cmc0619/PiTrac/Hardware/codex/Assembly Files/IRLED2 Only PCB/IRLED2 Only Assembly/IRLED2 Only Bill of Materials-codex.csv

Reference | Qty | Manufacturer | Part Number | Footprint
D6,D7,D8,D9,D10,D11,D12,D13,D14,D15 | 10 | Vishay Semiconductor Opto Division | VSMA1085400 | Pi Connector Parts-codex:VSMA1085400-codex
