cmc0619/PiTrac/Hardware/Schematic/V3 Connector + IRLED2 Schematic.pdf

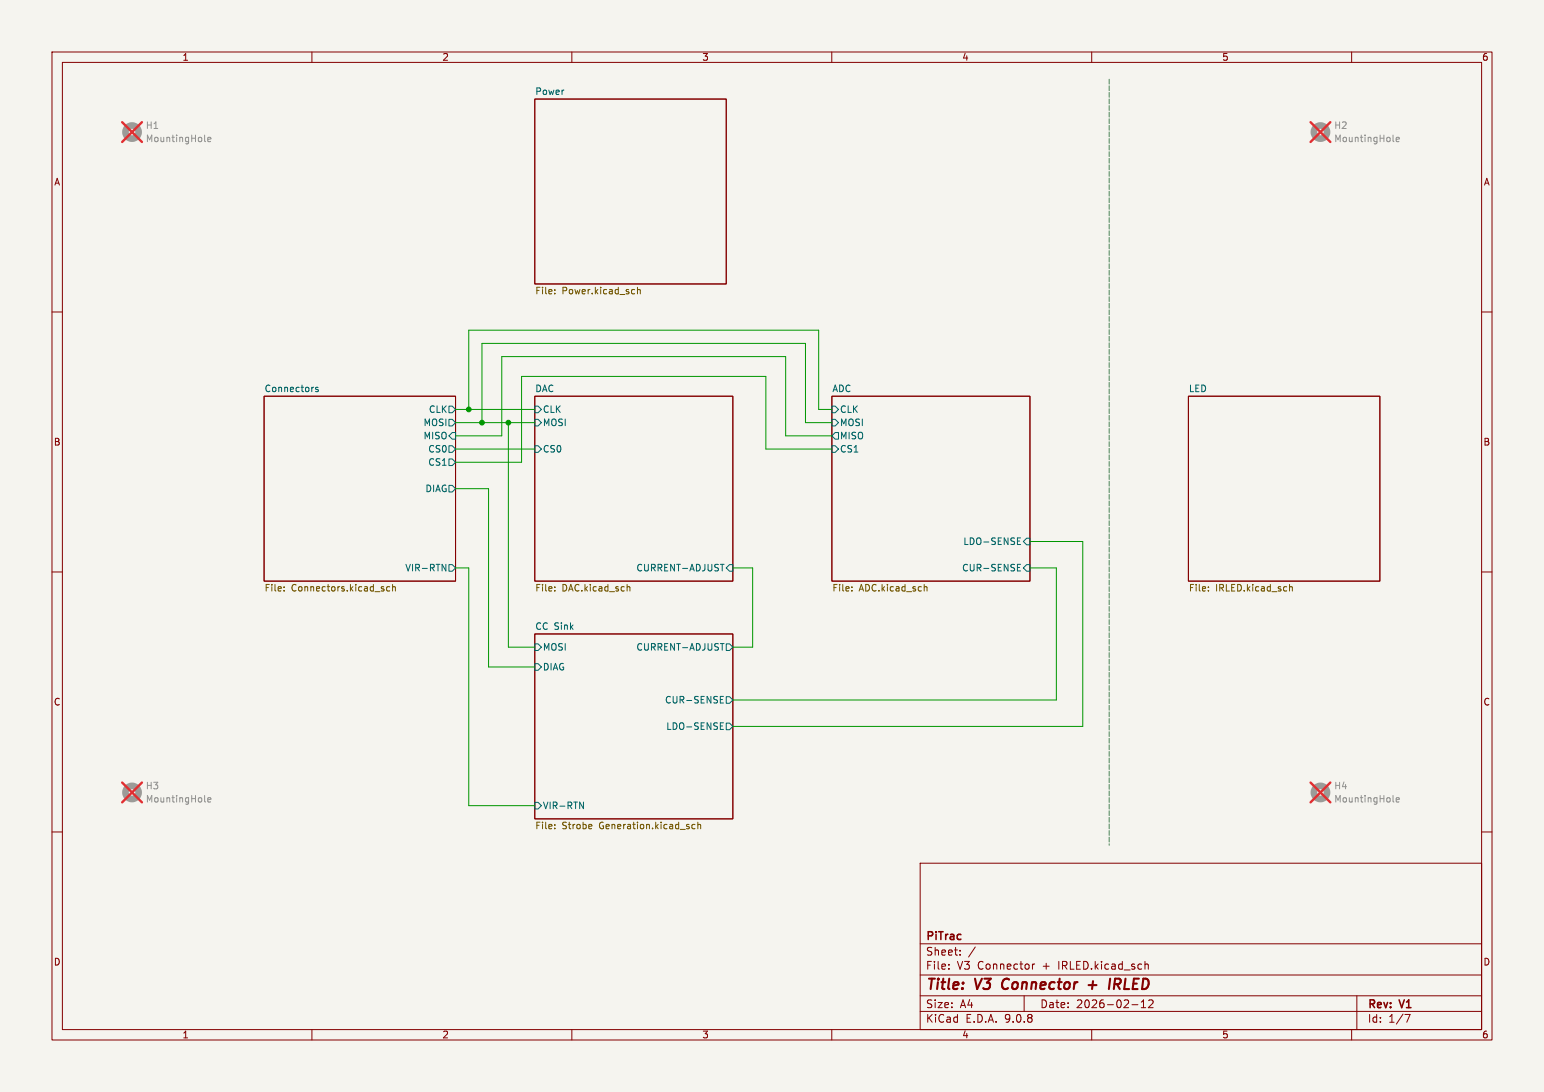
[picture p1: page 1]

CLK MOSI DIAG MISO

File: IRLED.kicad_sch VIR-RTN

LDO-SENSE CUR-SENSE CC Sink File: Strobe Generation.kicad_sch

Id: 1/7 Title: V3 Connector + IRLED

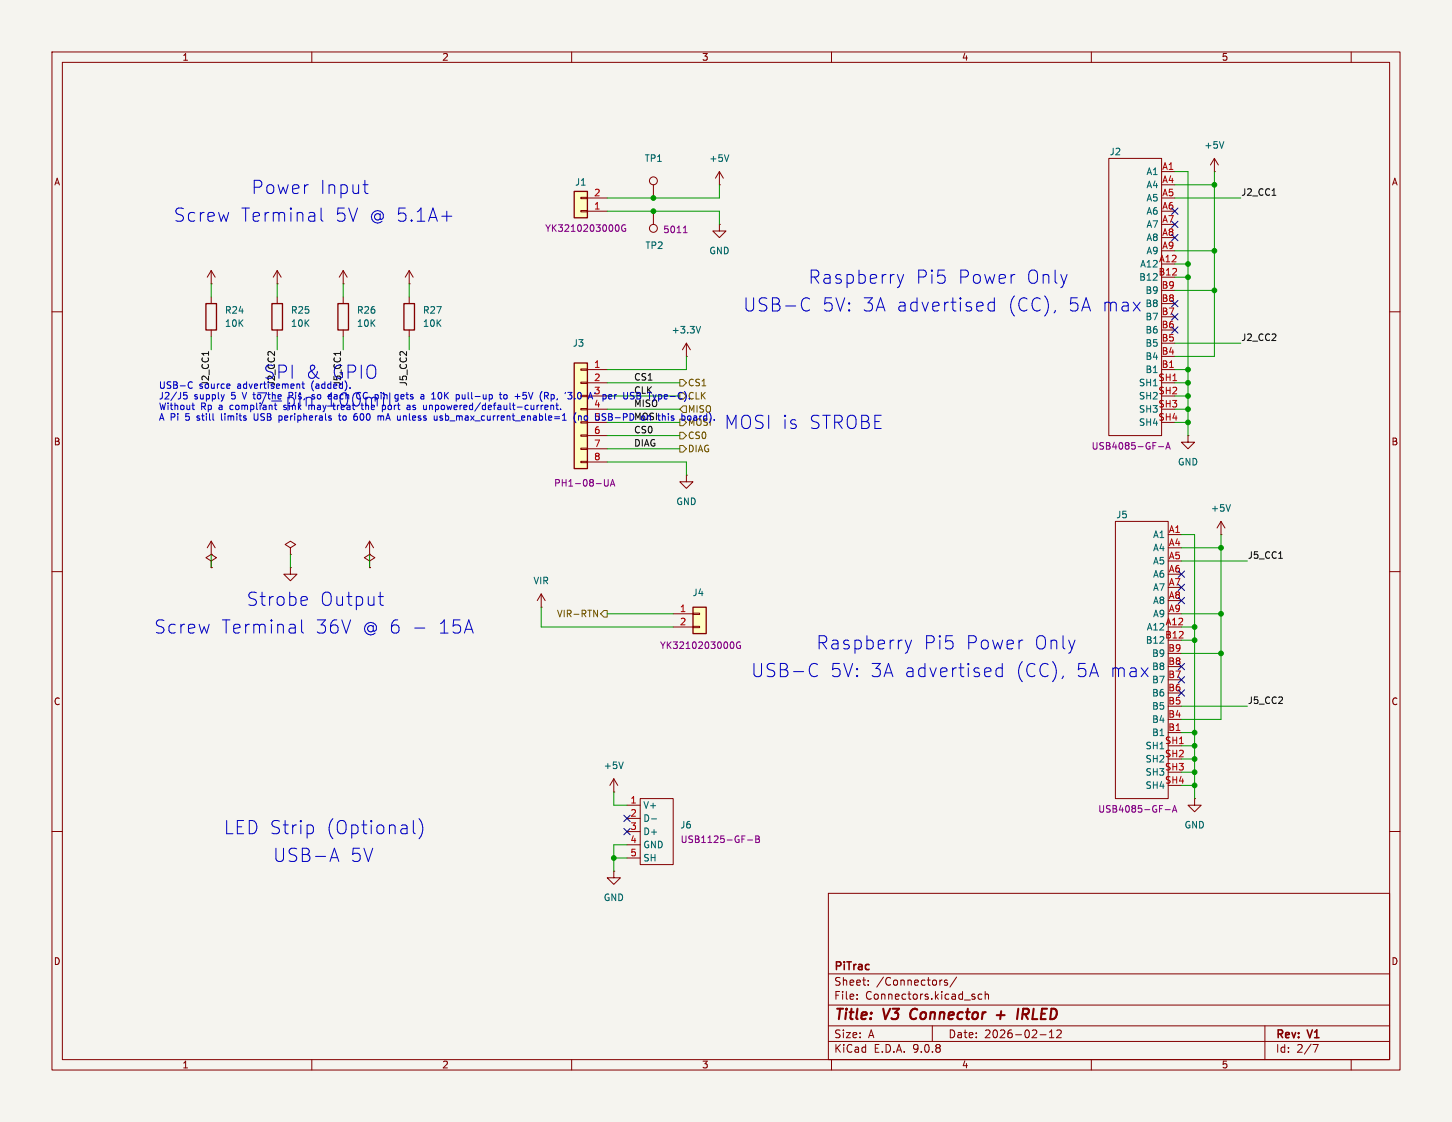
[picture p2: page 2]

File: Connectors.kicad_sch Sheet: /Connectors/ PiTrac

Id: 2/7 Title: V3 Connector + IRLED

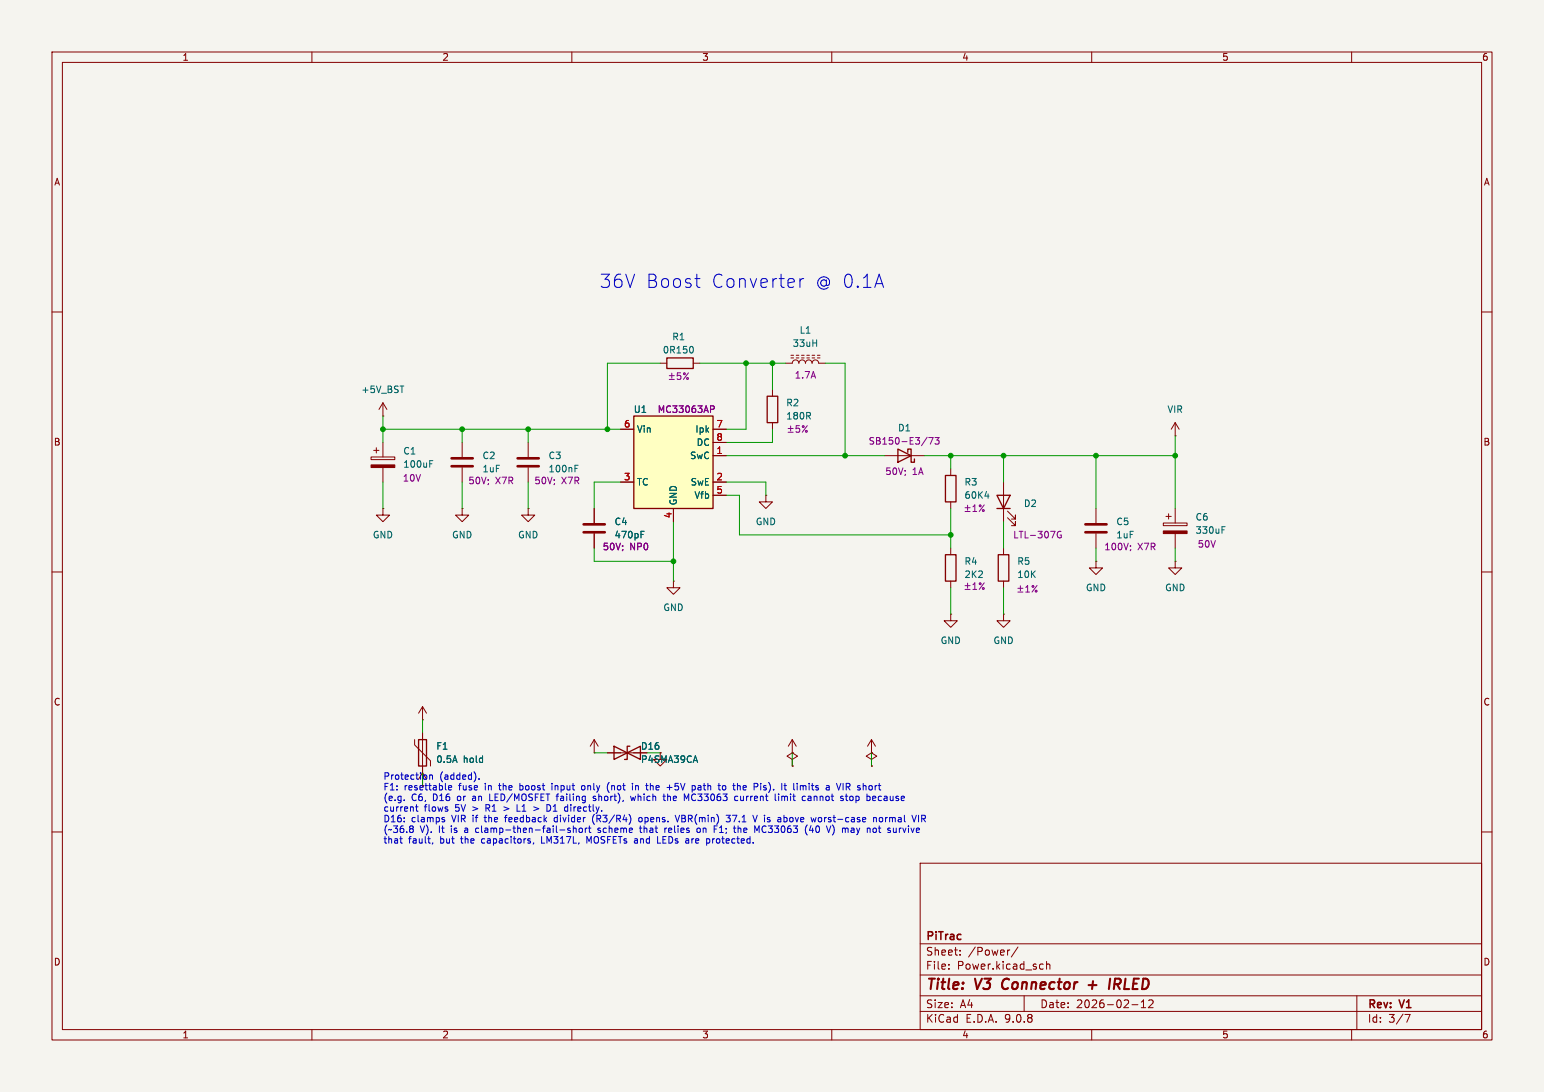
[picture p3: page 3]

File: Power.kicad_sch Sheet: /Power/ PiTrac

Id: 3/7 Title: V3 Connector + IRLED

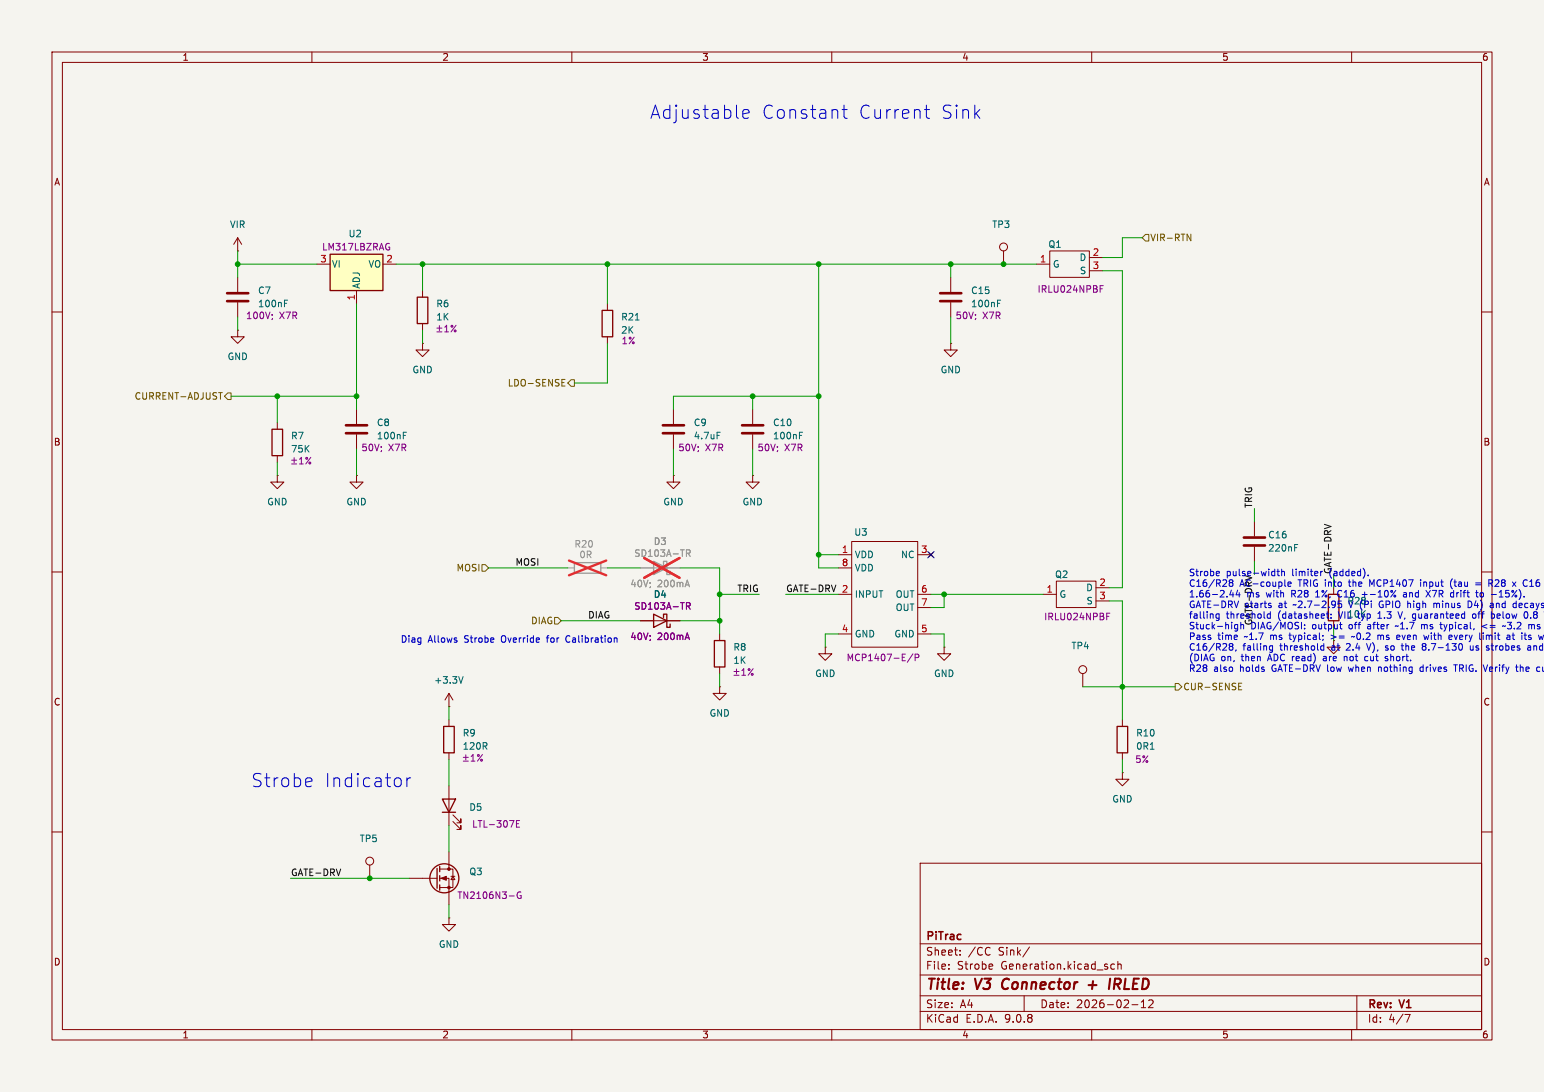
[picture p4: page 4]

CUR-SENSE GATE-DRV

File: Strobe Generation.kicad_sch Sheet: /CC Sink/ PiTrac

Id: 4/7 Title: V3 Connector + IRLED

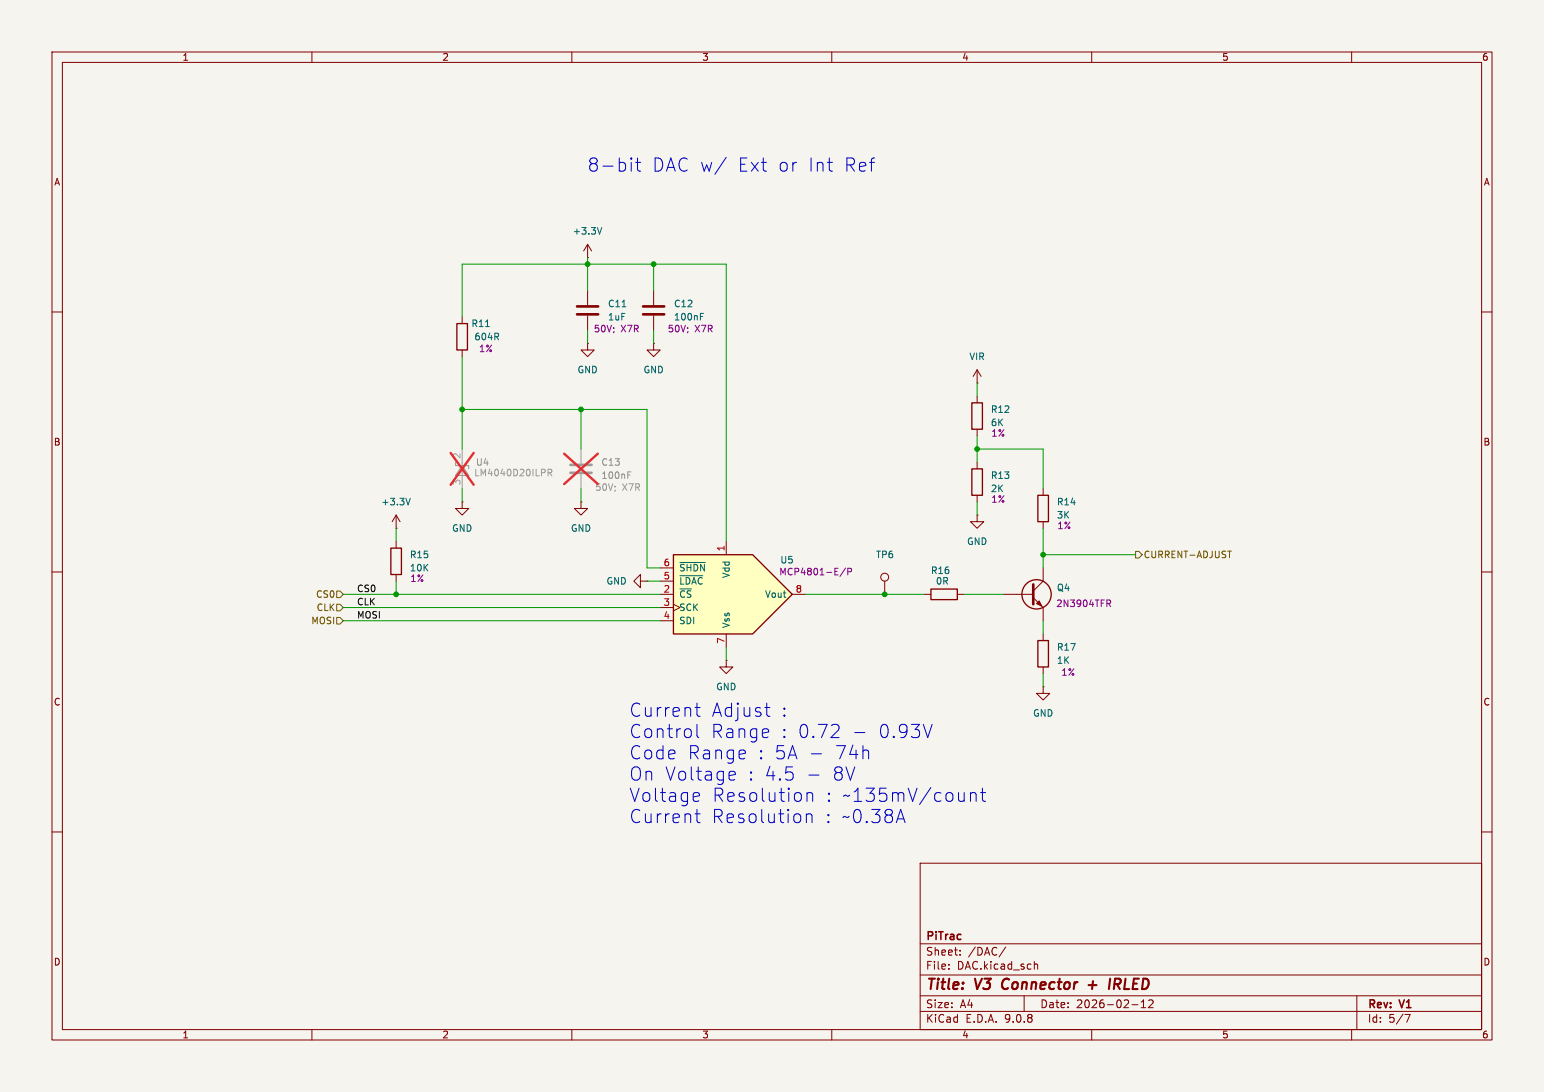
[picture p5: page 5]

Id: 5/7 Title: V3 Connector + IRLED

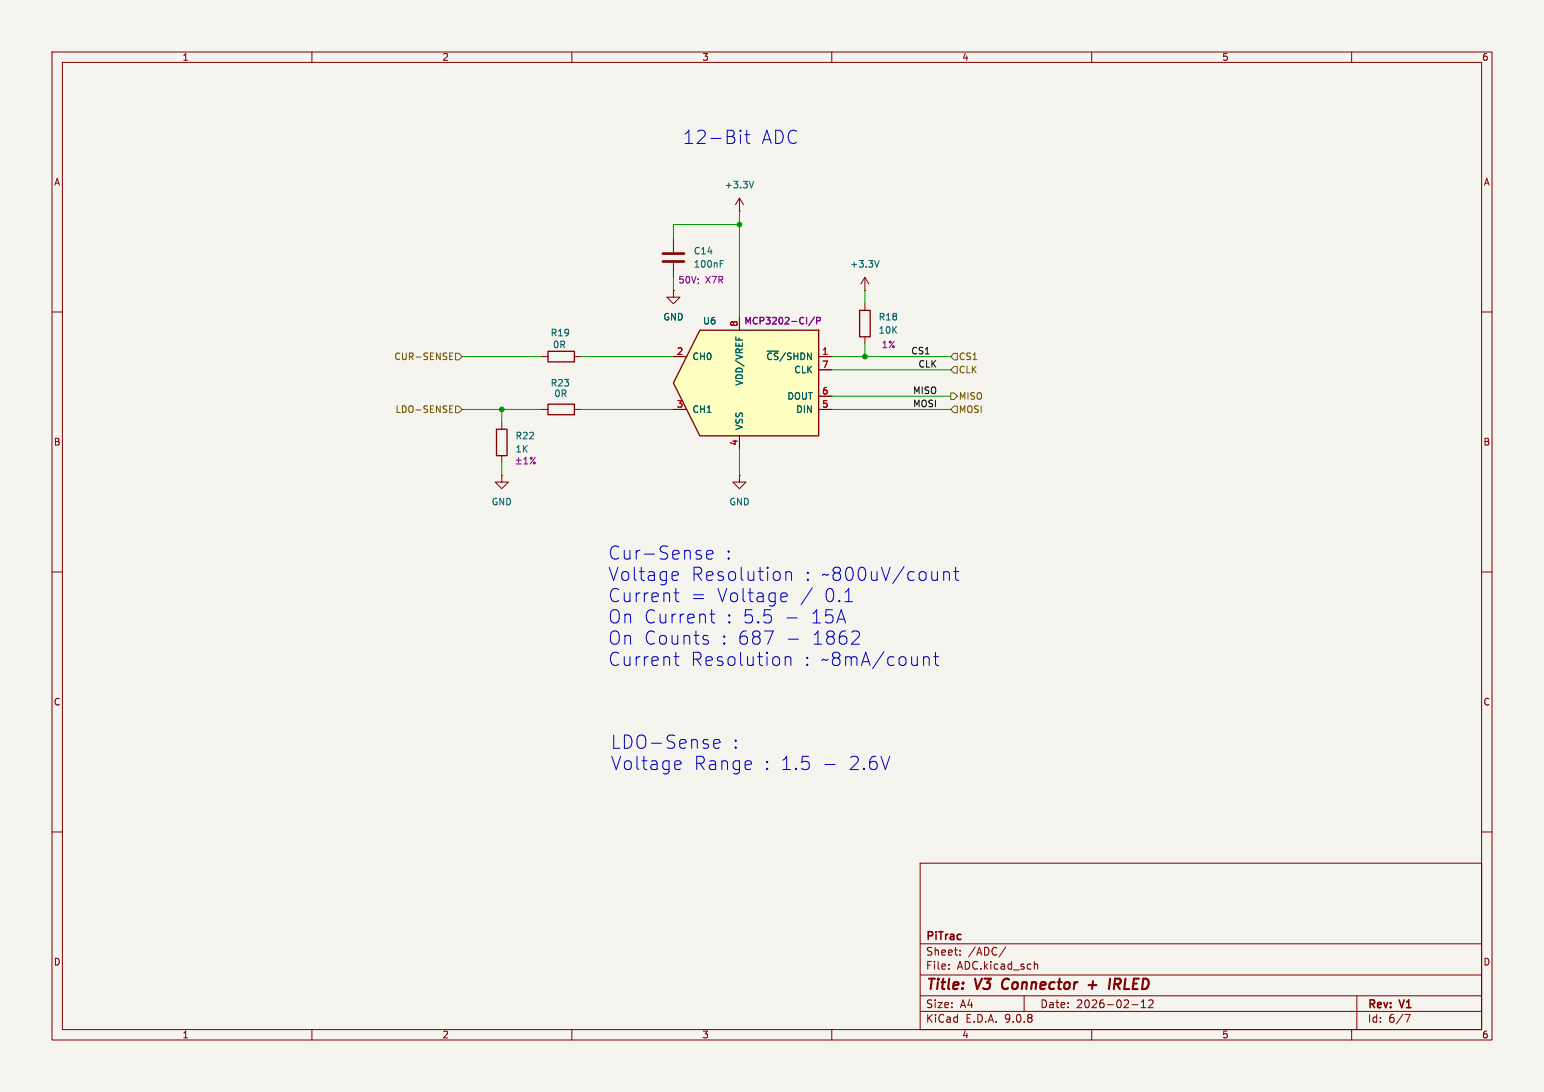
[picture p6: page 6]

4 ~{CS}/SHDN 1 CLK 7 DOUT 6 DIN 5 GND

4 ~{CS}/SHDN 1 CLK 7 DOUT 6 DIN 5 U6 MCP3202-CI/P GND

File: ADC.kicad_sch Sheet: /ADC/ PiTrac

Id: 6/7 Title: V3 Connector + IRLED

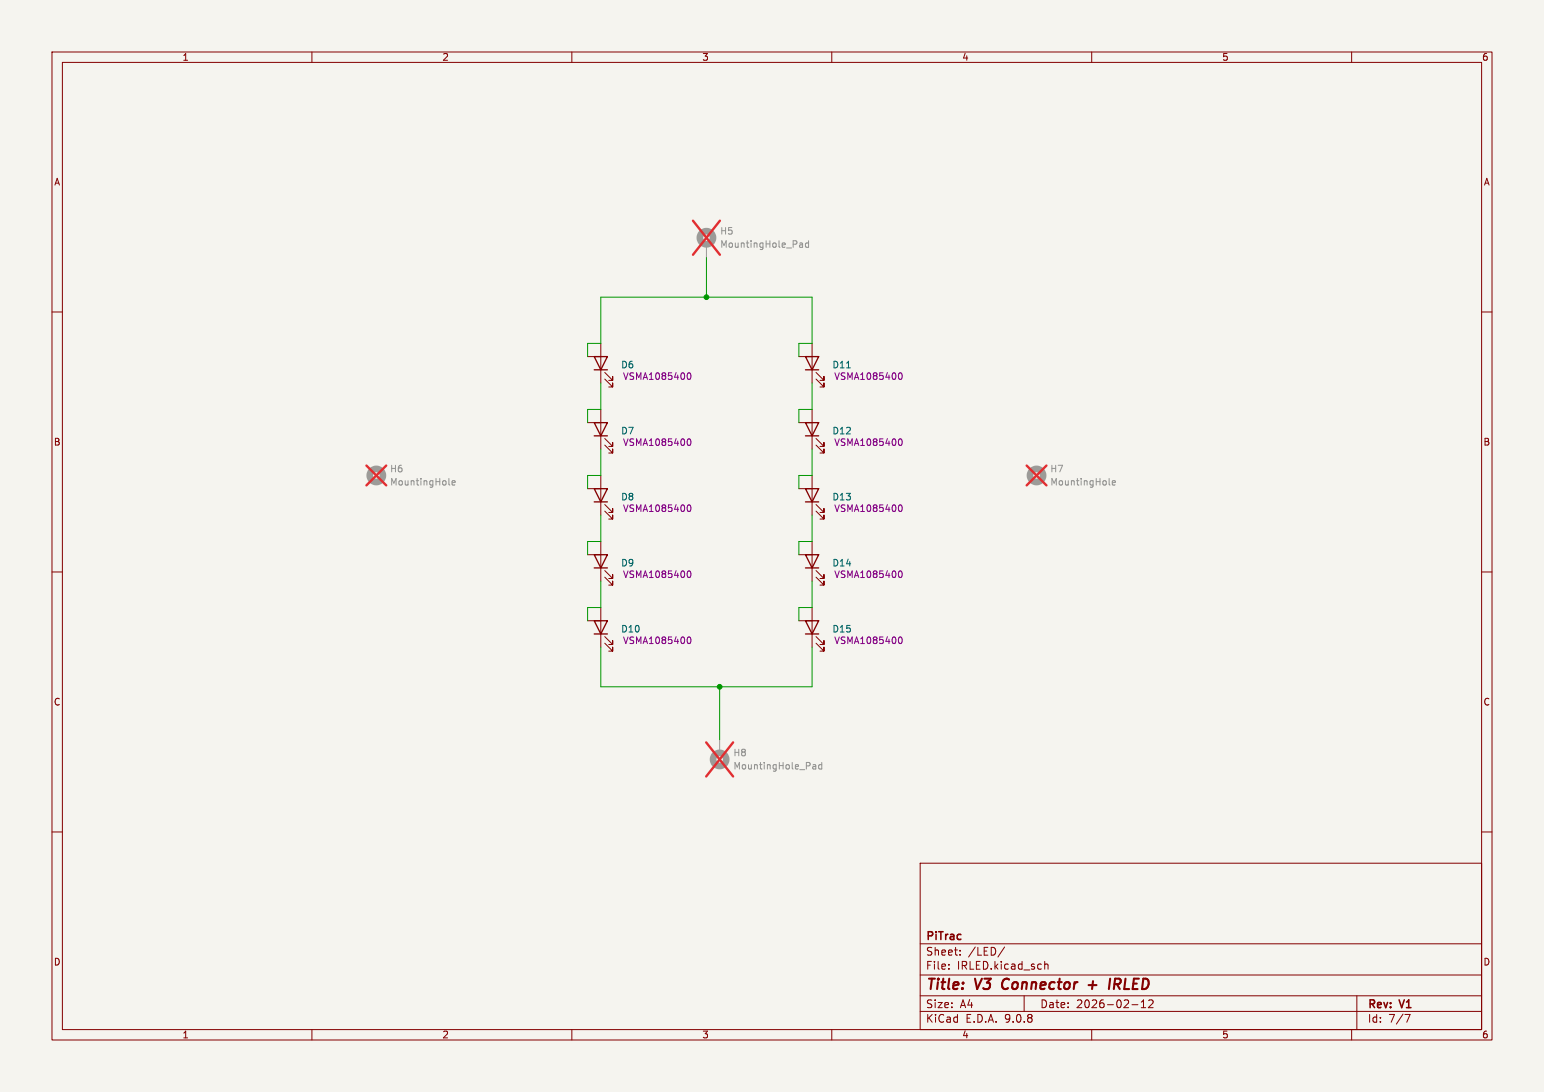
[picture p7: page 7]

File: IRLED.kicad_sch Sheet: /LED/ PiTrac

Id: 7/7 Title: V3 Connector + IRLED
