cmc0619/PiTrac/Hardware/codex/Schematic/V3 Connector + IRLED2 Schematic-codex.pdf

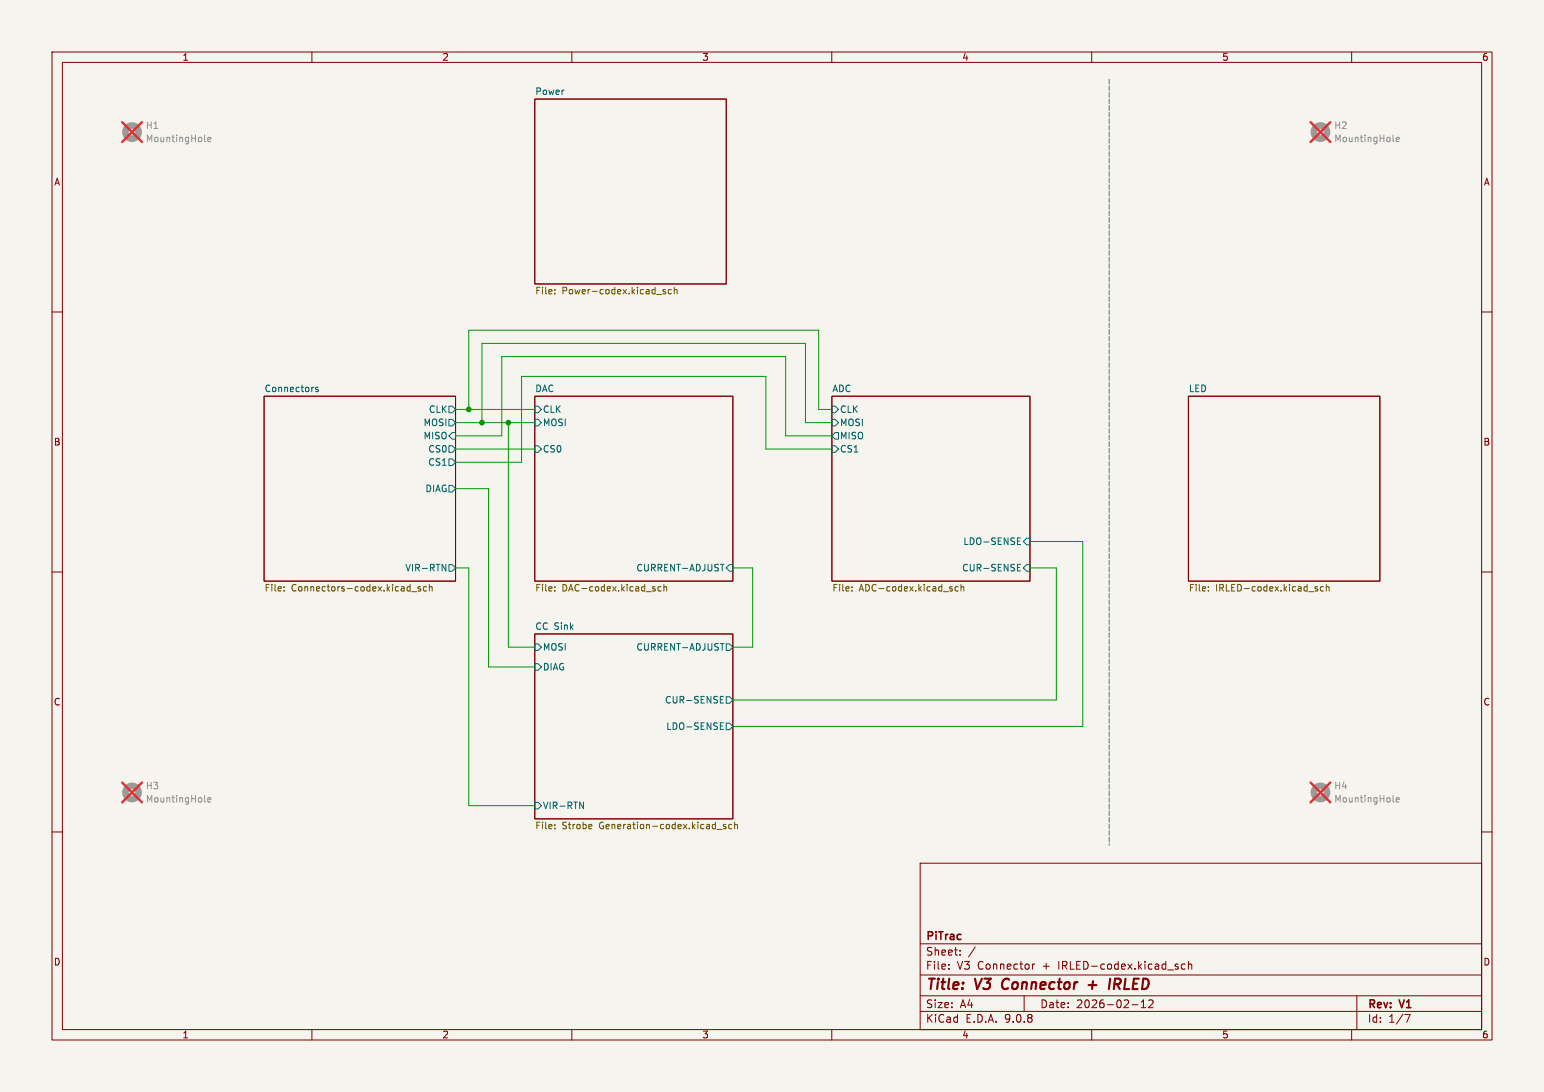
[picture p8: page 1]

Power File: Power-codex.kicad_sch

CLK MOSI DIAG MISO

File: IRLED-codex.kicad_sch VIR-RTN

LDO-SENSE CUR-SENSE CC Sink File: Strobe Generation-codex.kicad_sch

Id: 1/7 Title: V3 Connector + IRLED

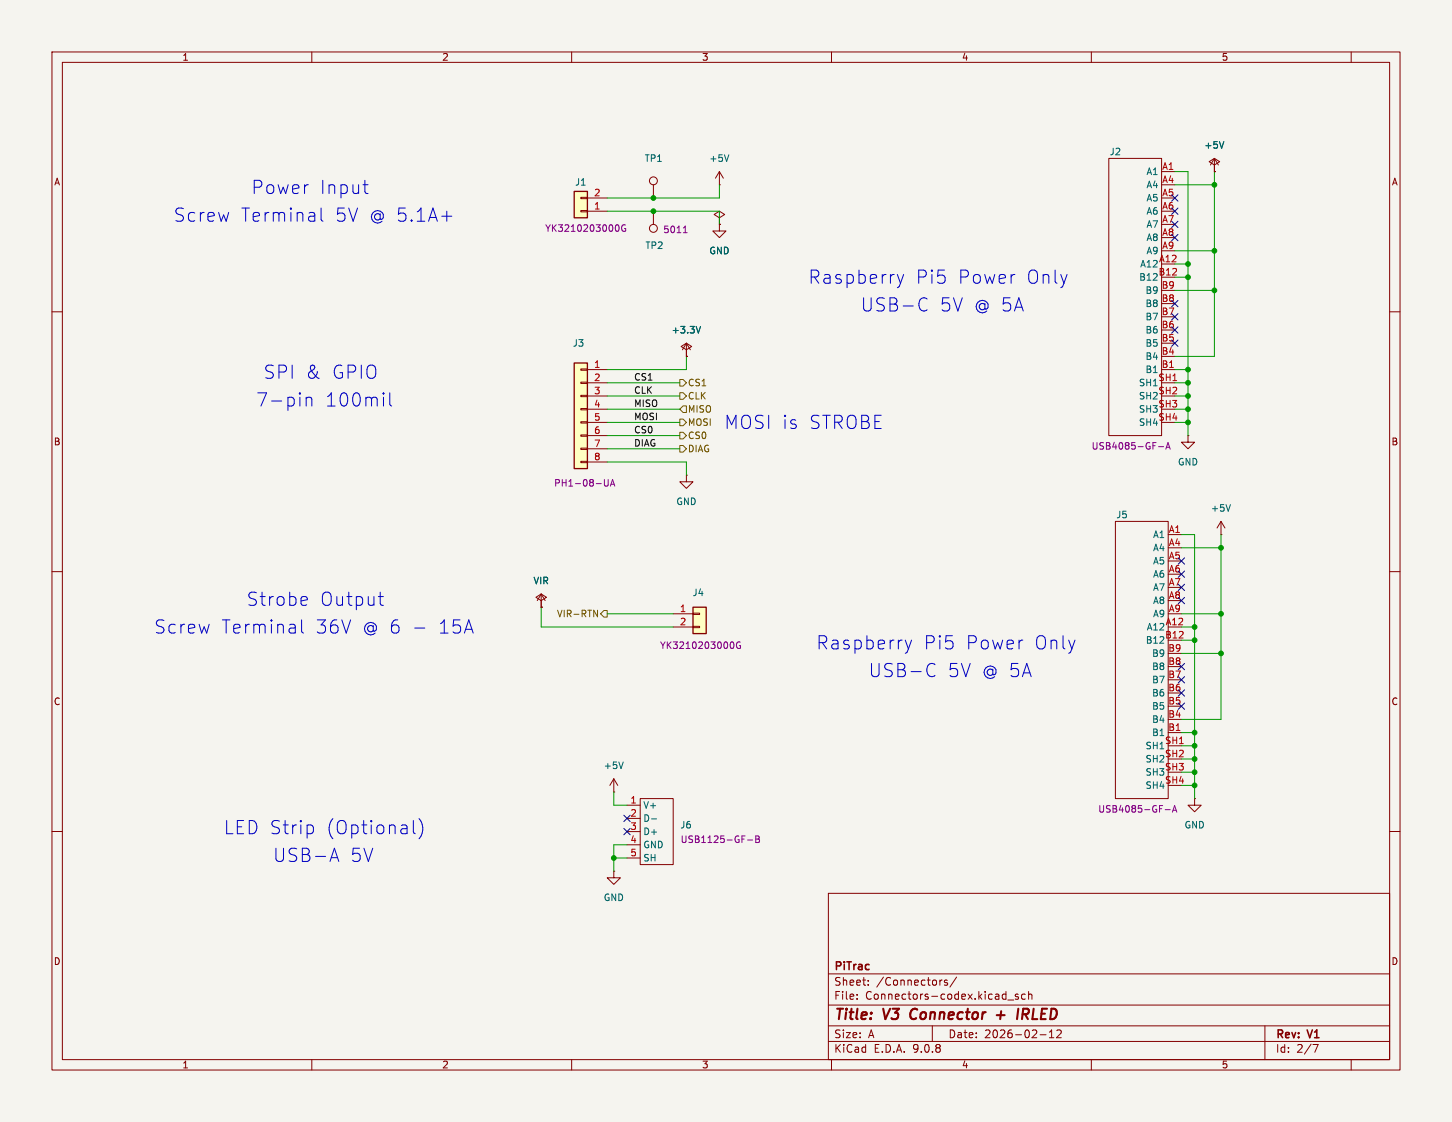
[picture p9: page 2]

SPI & GPIO
DIAG MOSI CS0 CS1 CLK USB-A 5V

File: Connectors-codex.kicad_sch Sheet: /Connectors/ PiTrac

Id: 2/7 Title: V3 Connector + IRLED

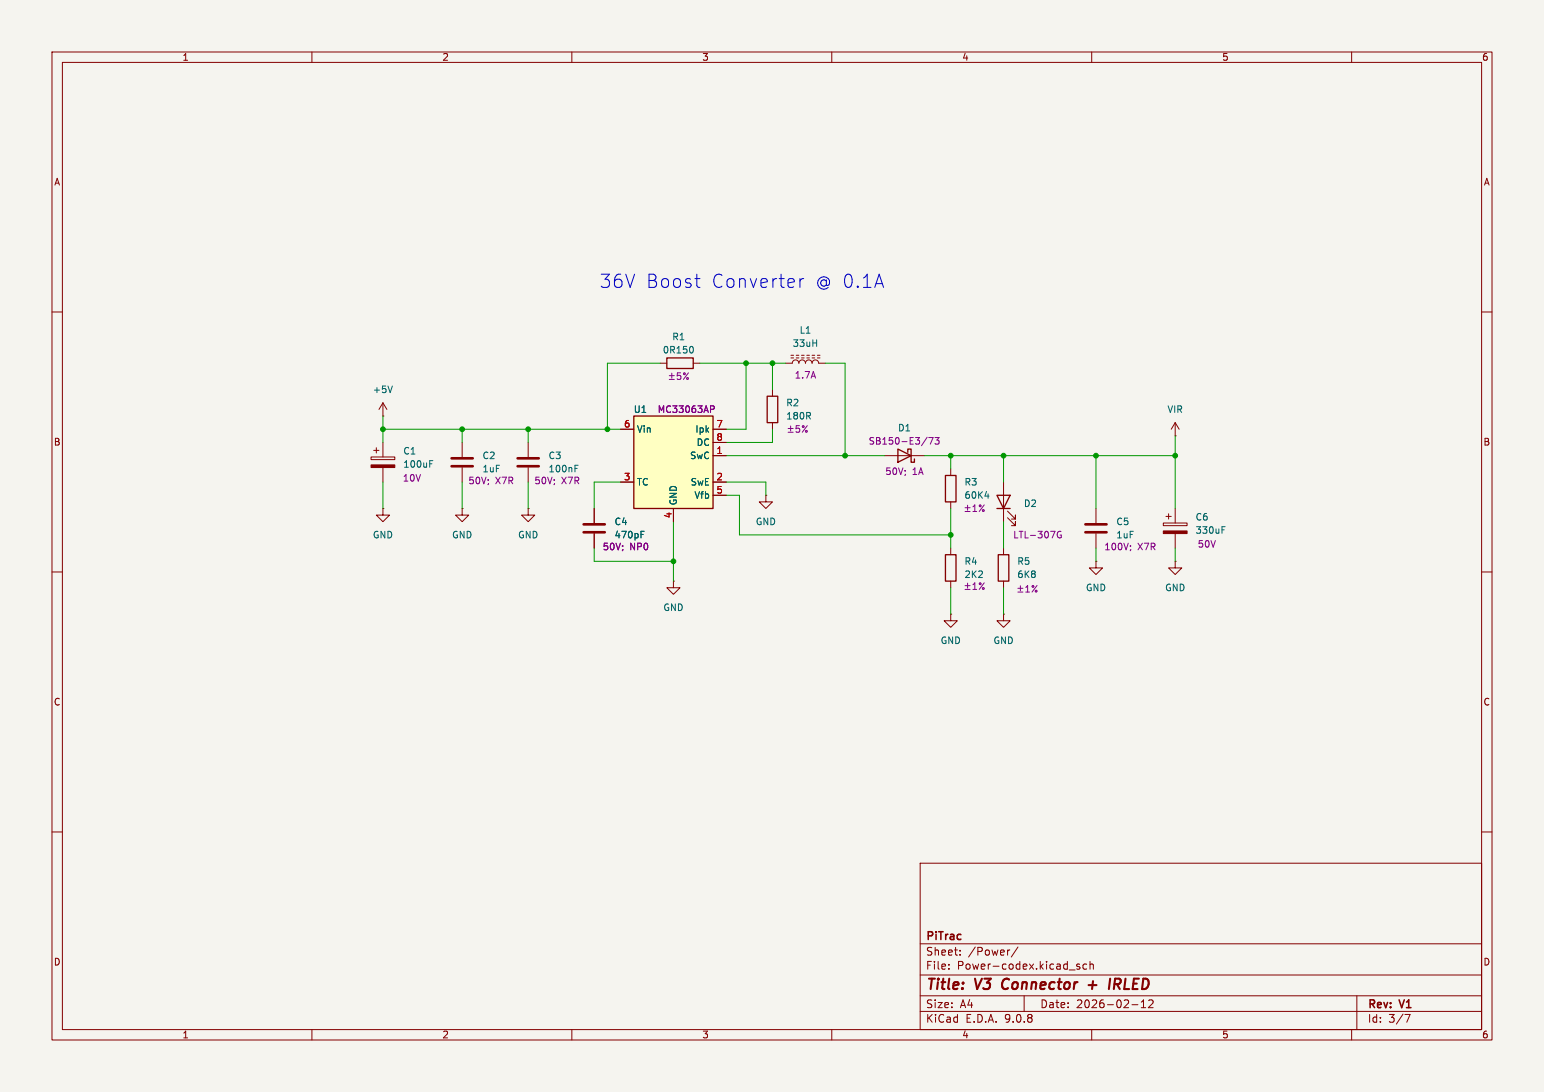
[picture p10: page 3]

File: Power-codex.kicad_sch Sheet: /Power/ PiTrac

Id: 3/7 Title: V3 Connector + IRLED

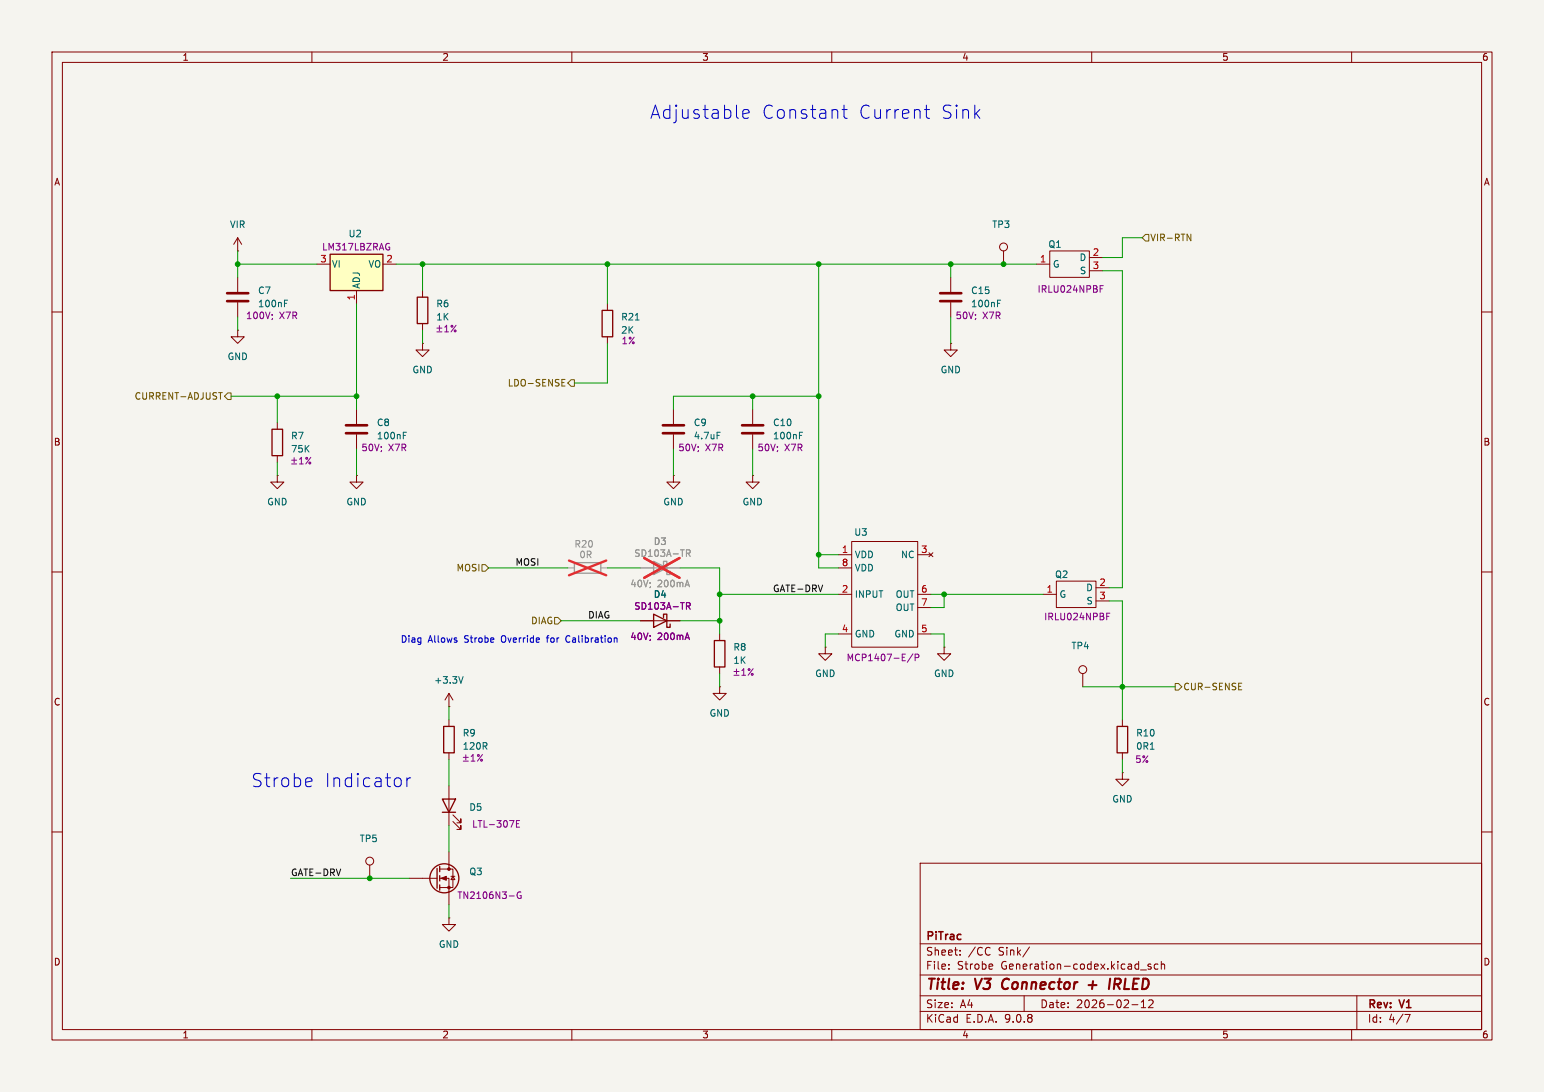
[picture p11: page 4]

File: Strobe Generation-codex.kicad_sch Sheet: /CC Sink/ PiTrac

Id: 4/7 Title: V3 Connector + IRLED

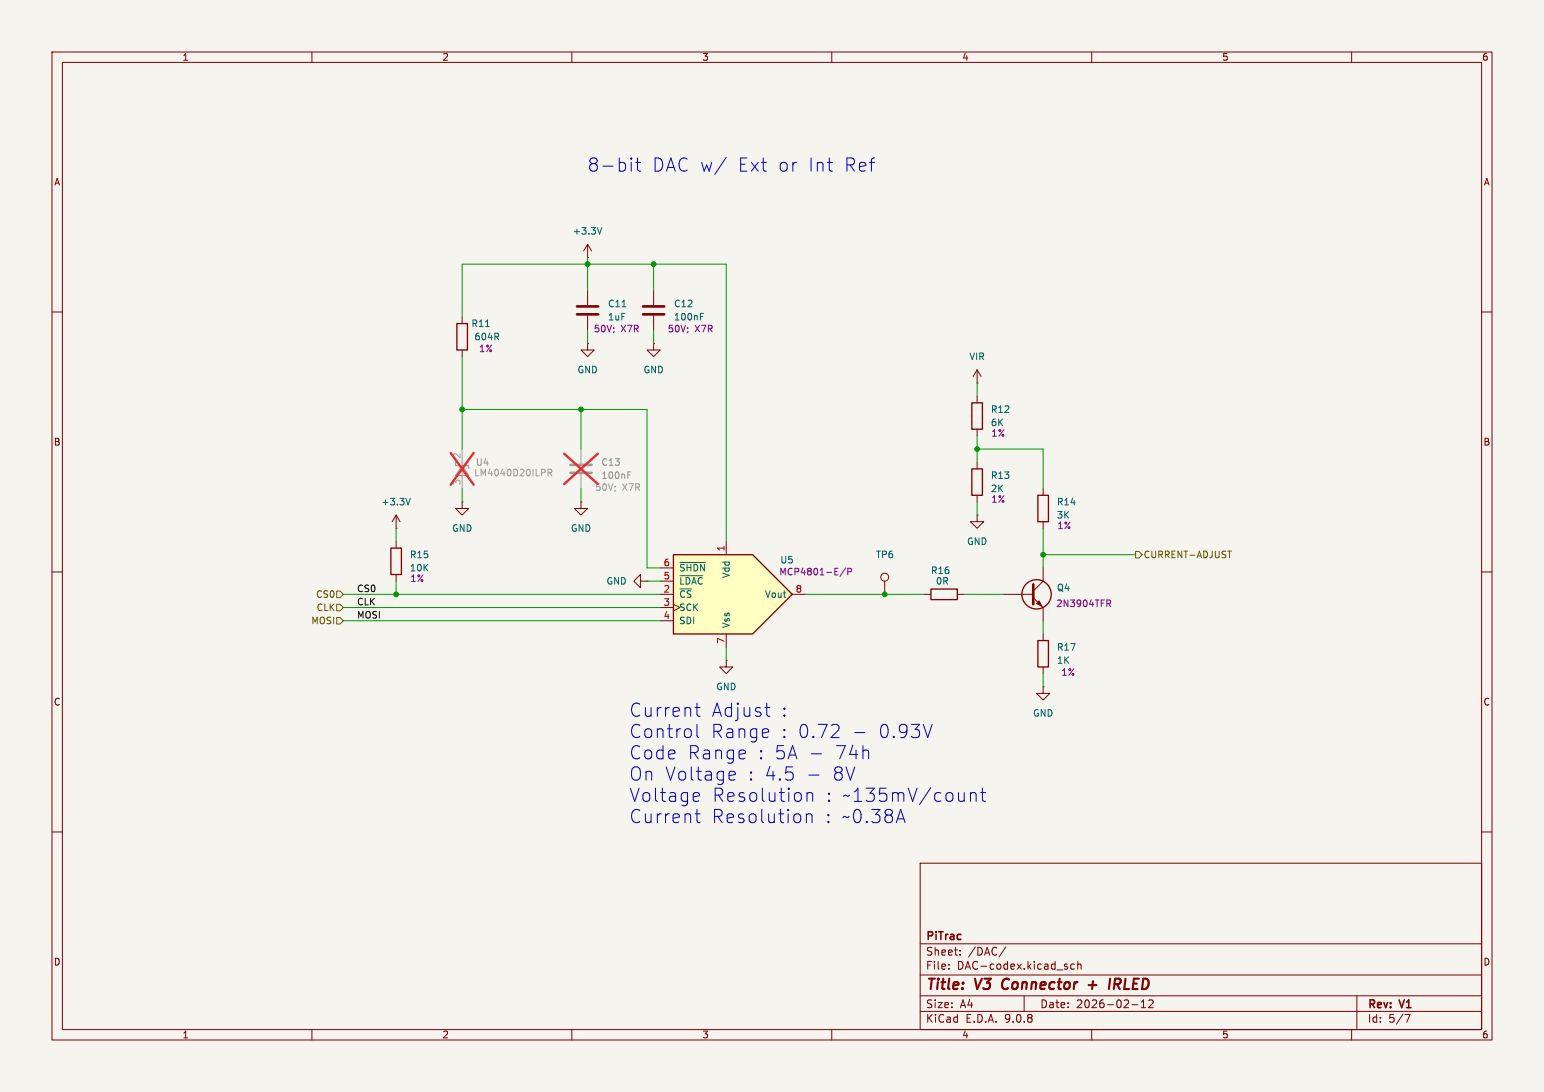
[picture p12: page 5]

Id: 5/7 Title: V3 Connector + IRLED

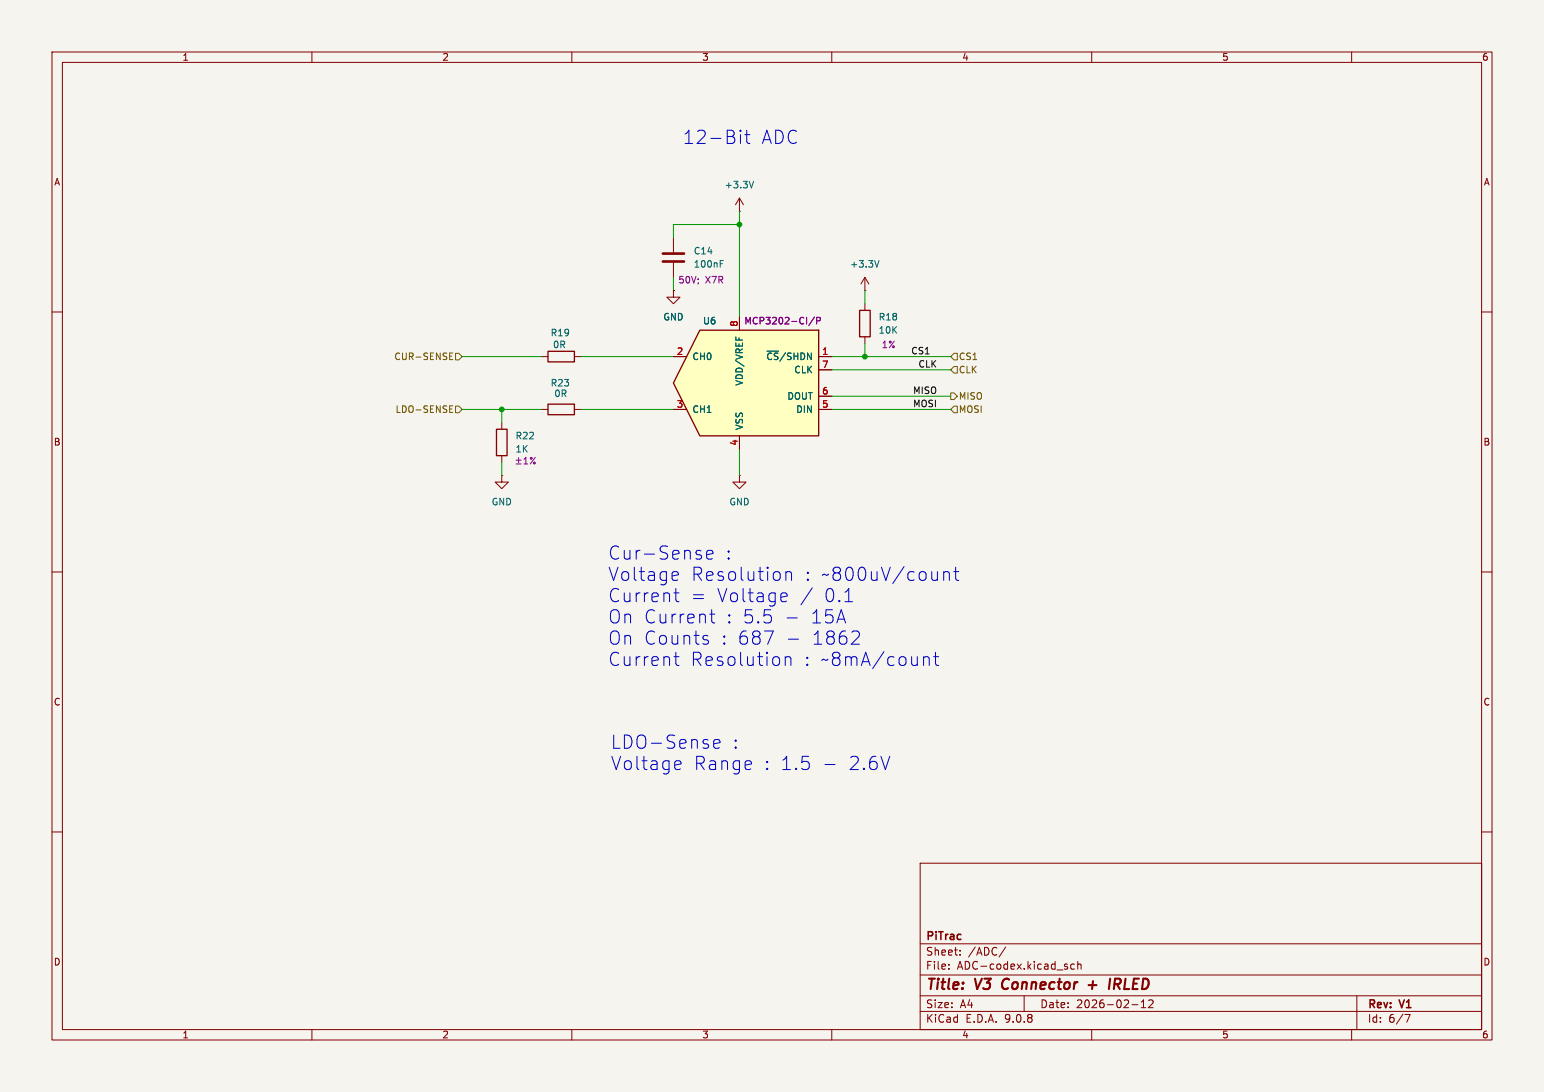
[picture p13: page 6]

4 ~{CS}/SHDN 1 CLK 7 DOUT 6 DIN 5 GND

4 ~{CS}/SHDN 1 CLK 7 DOUT 6 DIN 5 U6 MCP3202-CI/P GND

File: ADC-codex.kicad_sch Sheet: /ADC/ PiTrac

Id: 6/7 Title: V3 Connector + IRLED

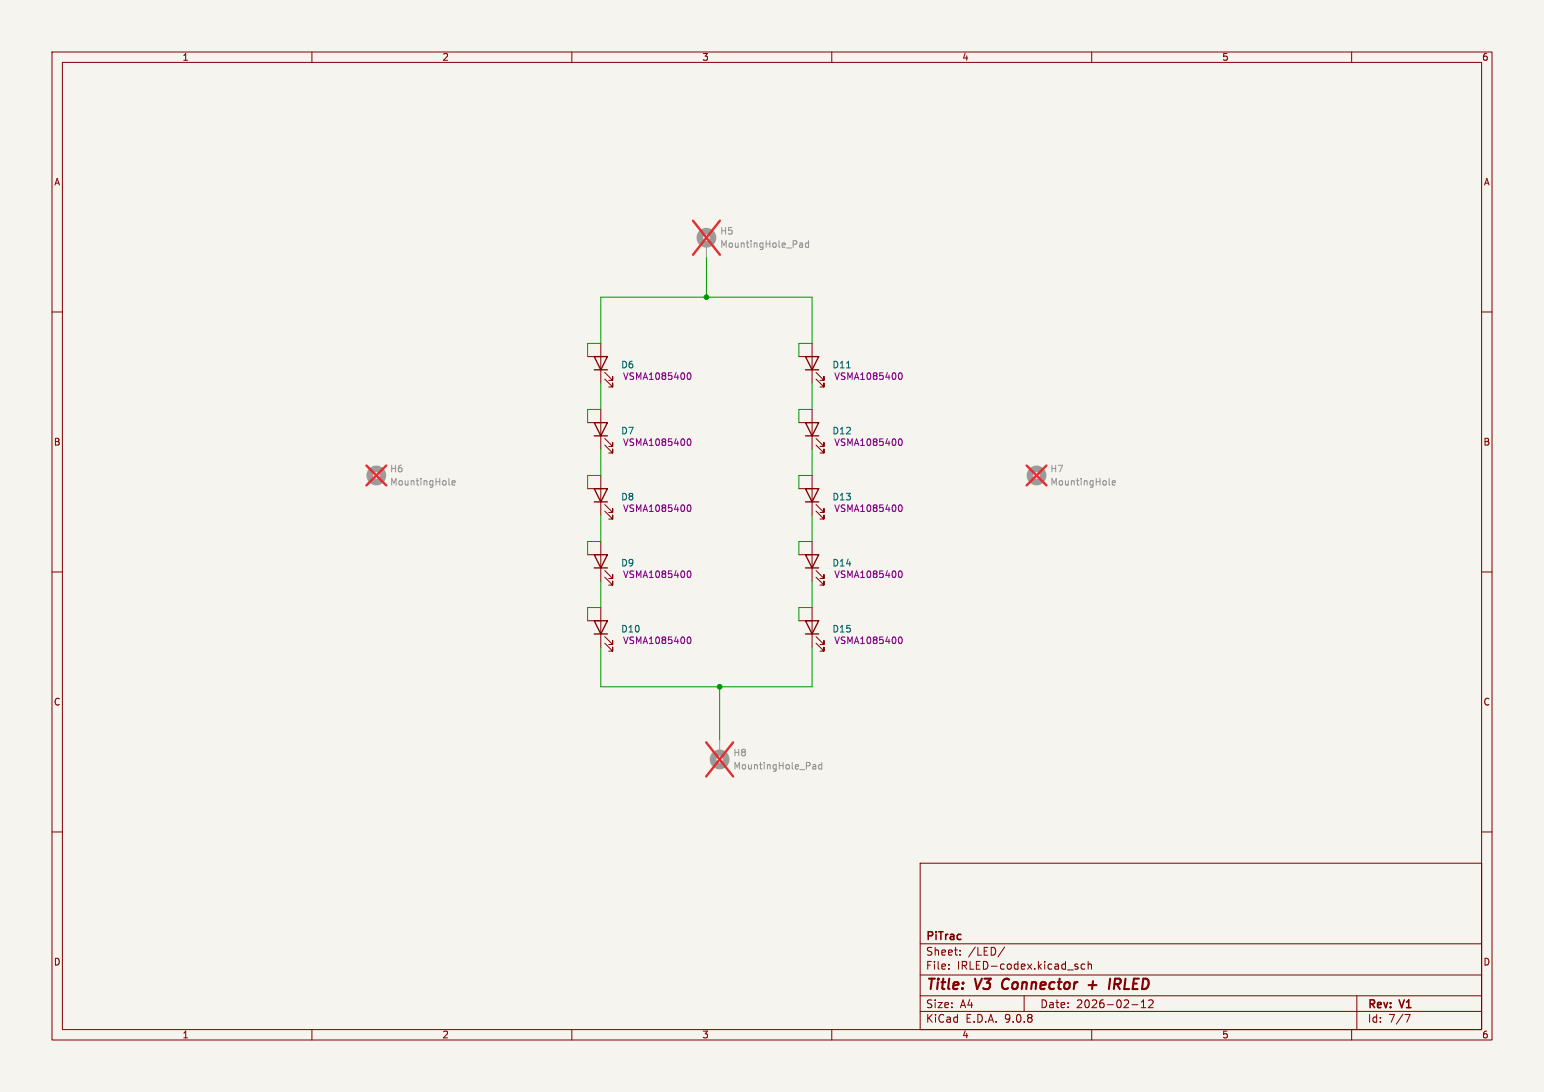
[picture p14: page 7]

File: IRLED-codex.kicad_sch Sheet: /LED/ PiTrac

Id: 7/7 Title: V3 Connector + IRLED
