cmc0619/PiTrac/Hardware/codex/KiCad Source Files/V3 Connector + IRLED-codex.kicad_pcb

## KiCad design Hardware/codex/KiCad Source Files/V3 Connector + IRLED-codex.kicad_pcb (2026-11-04)

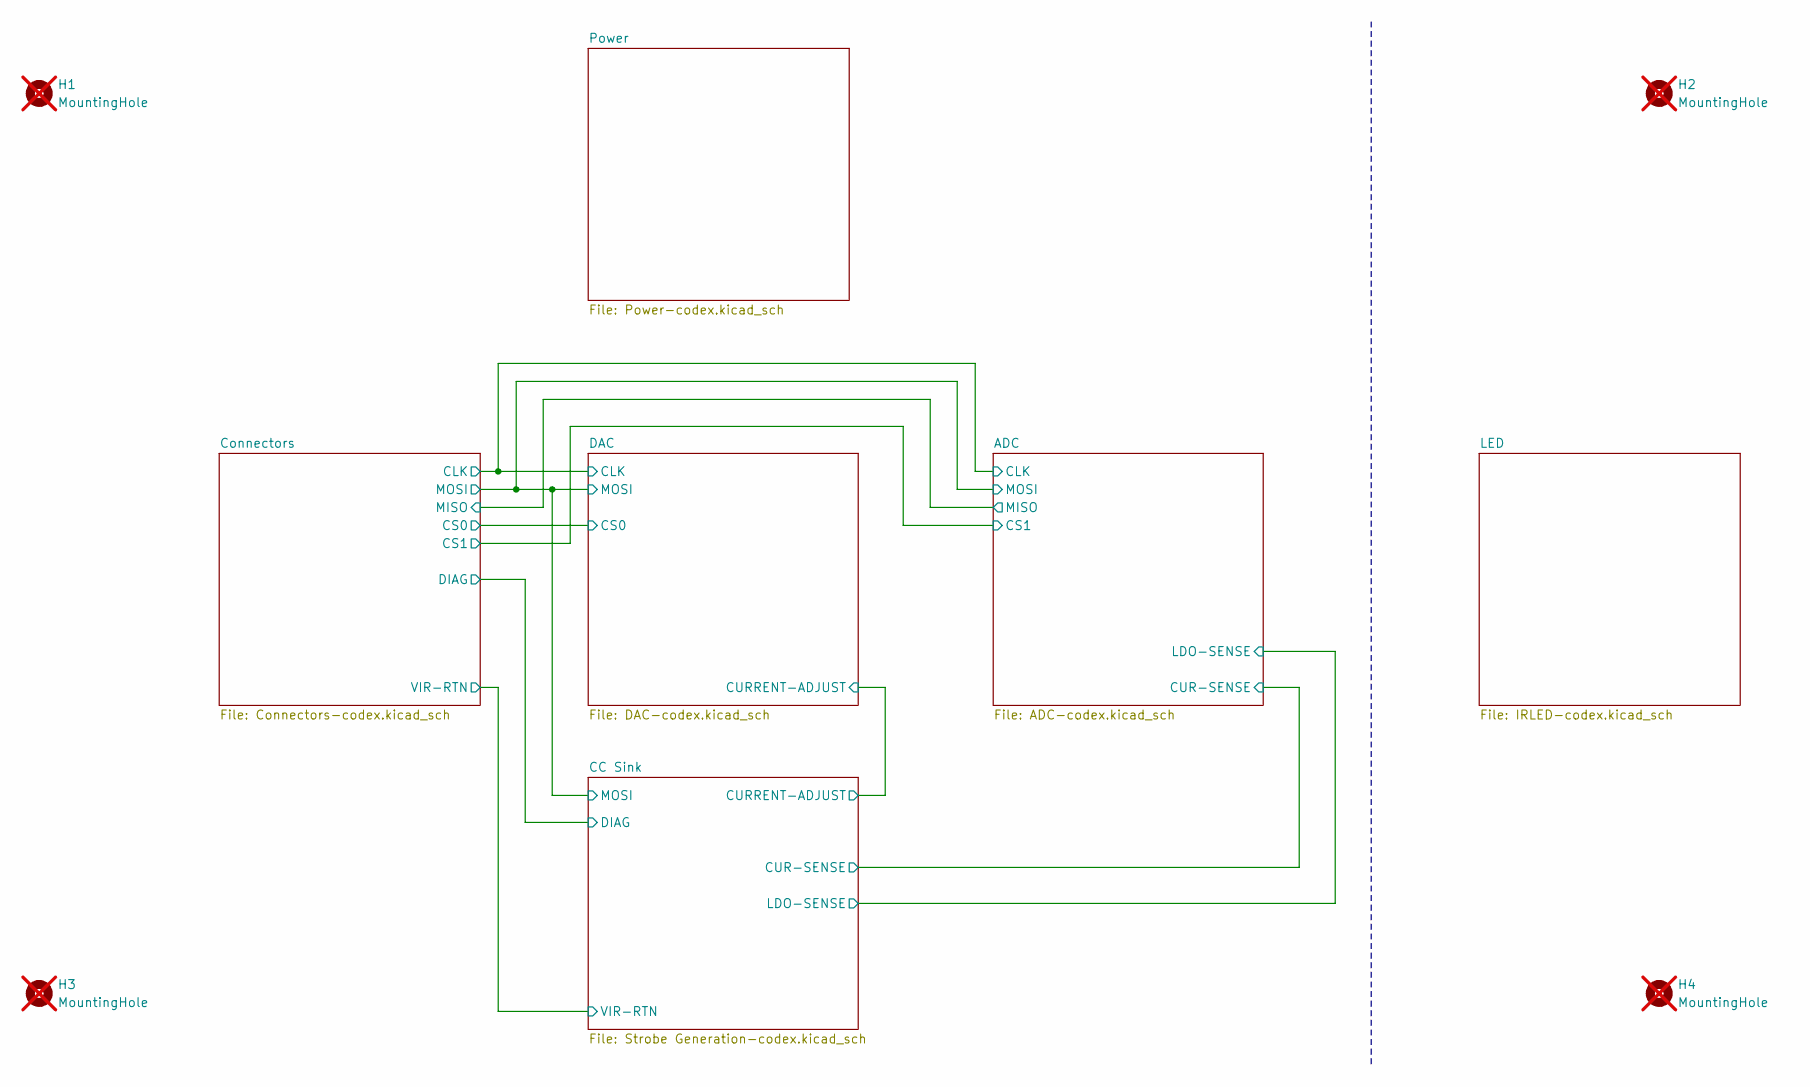
[picture p15: schematic V3 Connector + IRLED-codex.kicad_sch, V3 Connector + IRLED]

Parts:
H1, H2, H3, H4: MountingHole; MountingHole_3.5mm; not fitted

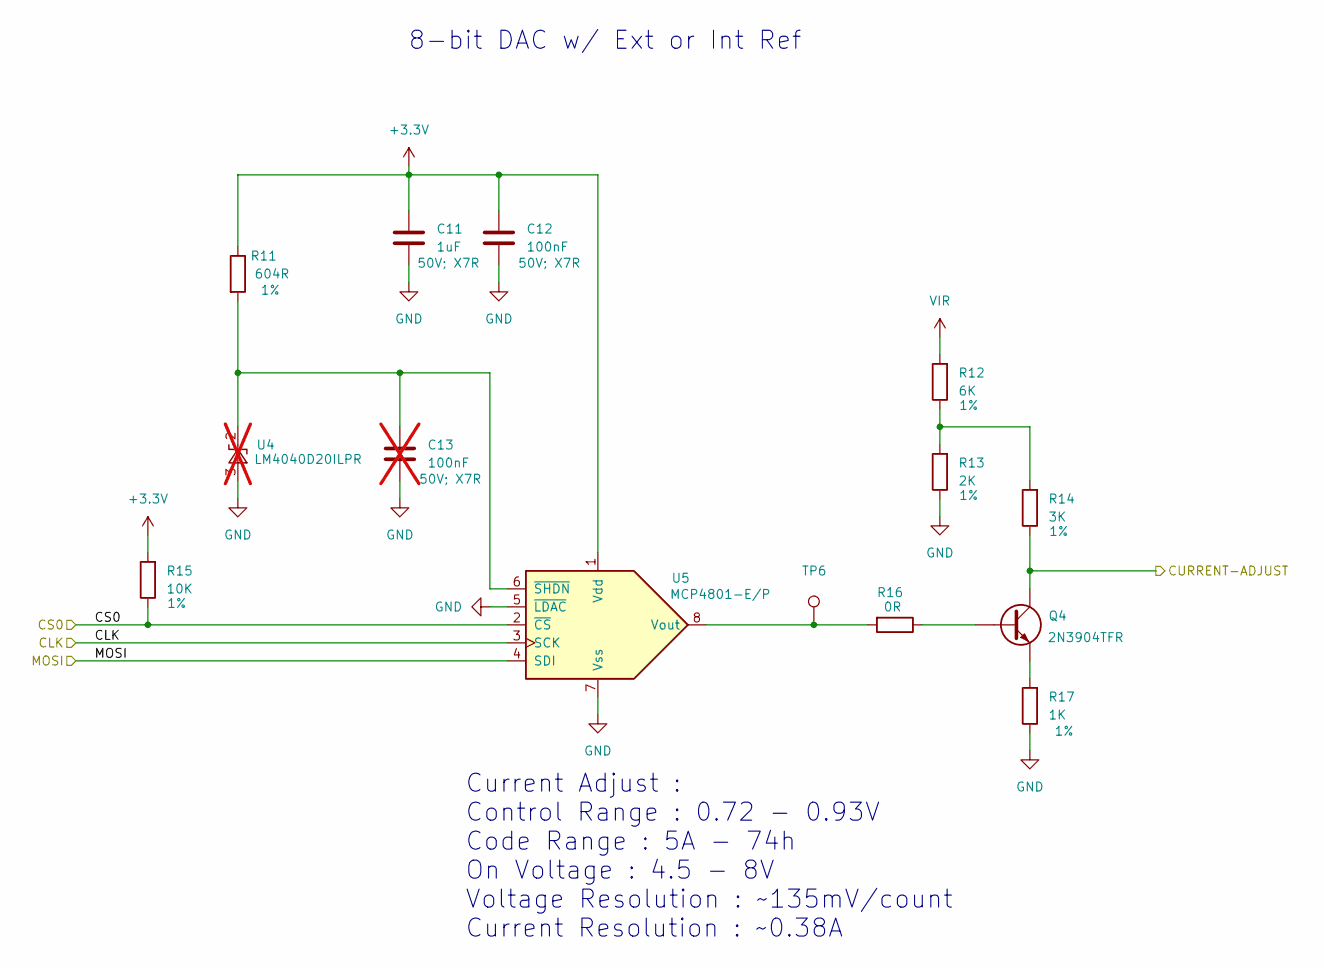
[picture p16: schematic DAC-codex.kicad_sch, V3 Connector + IRLED]

Parts:
C11: 1uF; C_Disc_D5.1mm_W3.2mm_P5.00mm; Ratings 50V; X7R; Part Number K105K20X7RF5TH5
C12: 100nF; C_Disc_D4.3mm_W1.9mm_P5.00mm; Ratings 50V; X7R; Part Number K104K10X7RF5UH5
C13: 100nF; C_Disc_D4.3mm_W1.9mm_P5.00mm; Ratings 50V; X7R; Part Number K104K10X7RF5UH5; not fitted
Q4: TO-92_Inline_Wide; Part Number 2N3904TFR
R11: 604R; R_Axial_DIN0207_L6.3mm_D2.5mm_P7.62mm_Horizontal; Ratings 1%; Part Number MFR-25FRF52-604R
R12: 6K; R_Axial_DIN0207_L6.3mm_D2.5mm_P7.62mm_Horizontal; Ratings 1%; Part Number MFR-25FBF52-6K04
R13: 2K; R_Axial_DIN0207_L6.3mm_D2.5mm_P7.62mm_Horizontal; Ratings 1%; Part Number MFR-25FRF52-2K
R14: 3K; R_Axial_DIN0207_L6.3mm_D2.5mm_P7.62mm_Horizontal; Ratings 1%; Part Number MFR-25FRF52-3K
R15: 10K; R_Axial_DIN0207_L6.3mm_D2.5mm_P15.24mm_Horizontal; Ratings 1%; Part Number MFR-25FRF52-10K
R16: 0R; R_Axial_DIN0207_L6.3mm_D2.5mm_P7.62mm_Horizontal; Part Number ZOR-25-R-52-0R
R17: 1K; R_Axial_DIN0207_L6.3mm_D2.5mm_P7.62mm_Horizontal; Ratings 1%; Part Number MFR-25FRF52-1K
TP6: TestPoint; TestPoint_Pad_D1.0mm
U4: LM4040LP-2.0; TO-92_Inline_Wide; Part Number LM4040D20ILPR; not fitted
U5: MCP4801; DIP-8_W7.62mm; Part Number MCP4801-E/P

Connections:
+3.3V: C11.1, C12.1, R11.1, R15.2, U5.1 (Vdd); also elsewhere on the board
/ADC/CLK: U5.3 (SCK); also elsewhere on the board
/ADC/MOSI: U5.4 (SDI); also elsewhere on the board
/CC Sink/CURRENT-ADJUST: Q4.3 (C), R14.1; also elsewhere on the board
/Connectors/CS0: R15.1, U5.2 (~CS); also elsewhere on the board
GND: C11.2, C12.2, C13.2, R13.1, R17.1, U4.3 (A), U5.5 (~LDAC), U5.7 (Vss); also elsewhere on the board
unnamed: Q4.2 (B), R16.1
unnamed: Q4.1 (E), R17.2
unnamed: R12.1, R13.2, R14.2
unnamed: C13.1, R11.2, U4.2 (K), U5.6 (~SHDN)
unnamed: R16.2, TP6.1, U5.8 (Vout)
VIR: R12.2; also elsewhere on the board

Notes on the sheet:
Current Adjust : Control Range : 0.72 - 0.93V Code Range : 5A - 74h On Voltage : 4.5 - 8V Voltage Resolution : ~135mV/count Current Resolution : ~0.38A
8-bit DAC w/ Ext or Int Ref

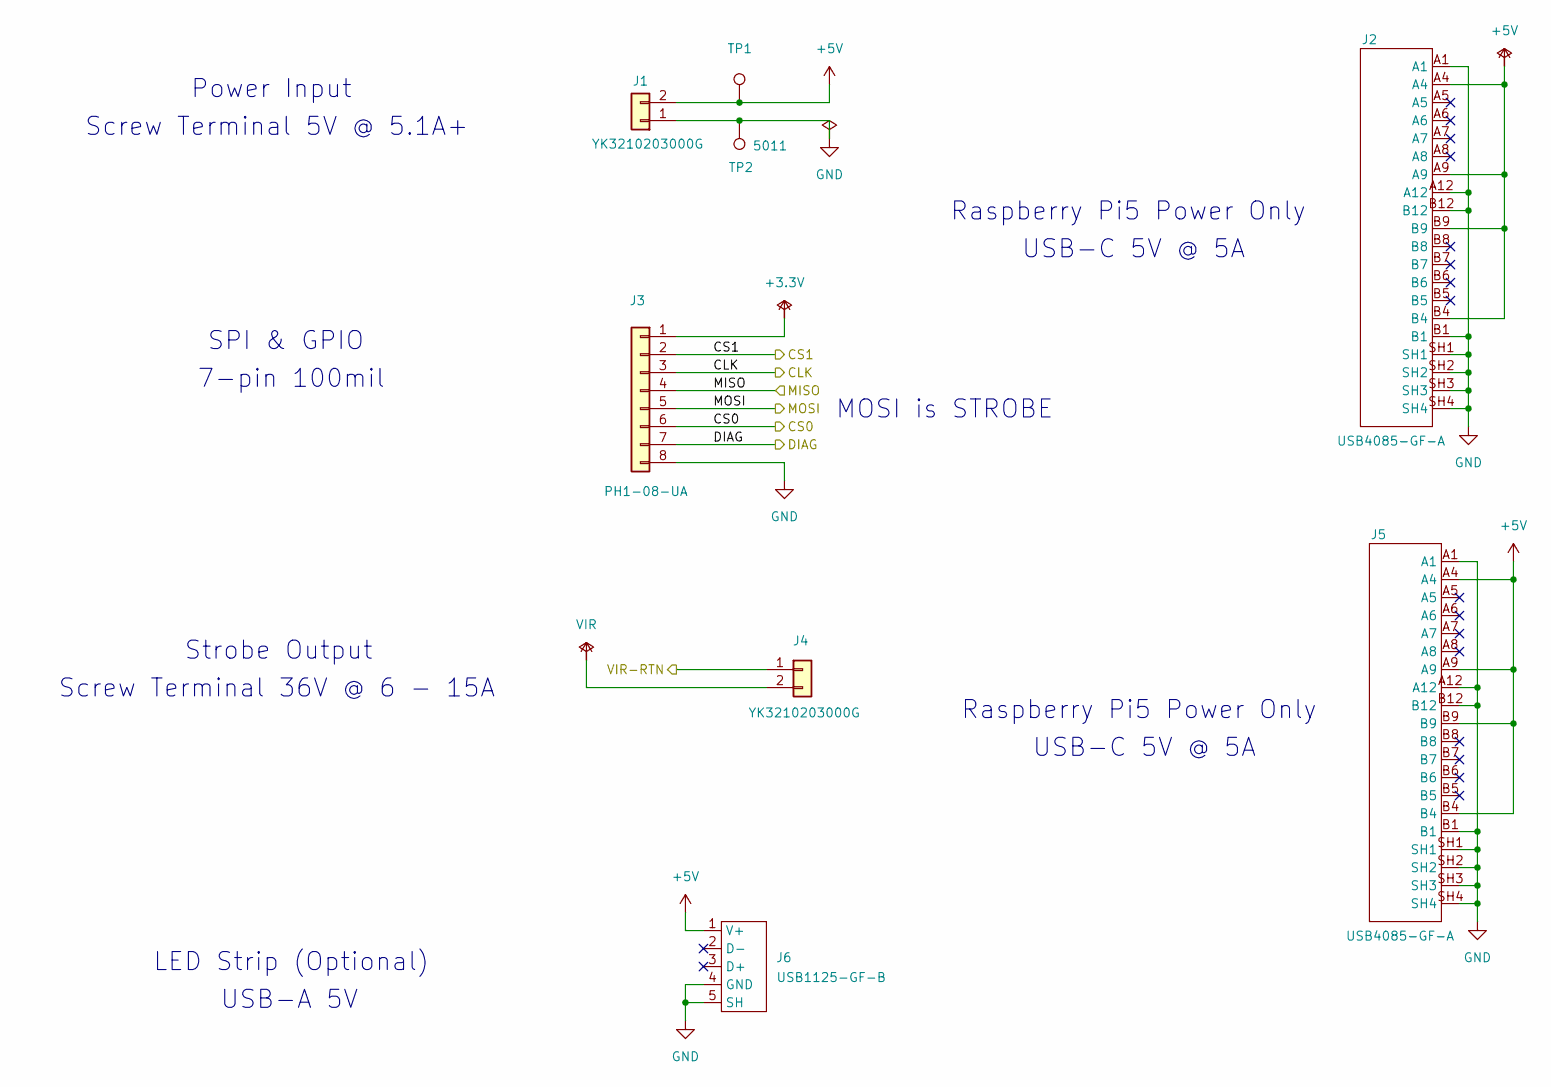
[picture p17: schematic Connectors-codex.kicad_sch, V3 Connector + IRLED]

Parts:
J1, J4: YK3210203000G; Part Number YK3210203000G
J2, J5: USB4085-GF-A; USB4085-GF-A-codex; Part Number USB4085-GF-A
J3: Conn_01x08; PinHeader_1x08_P2.54mm_Vertical; Part Number PH1-08-UA
J6: USB1125-GF-B; Part Number USB1125-GF-B
TP1: TestPoint; TestPoint_Pad_D1.0mm
TP2: TestPoint; TestPoint_Keystone_5010-5014_Multipurpose; Part Number 5011

Connections:
+3.3V: J3.1; also elsewhere on the board
+5V: J1.2, J2.A4, J2.A9, J2.B4, J2.B9, J5.A4, J5.A9, J5.B4, J5.B9, J6.1 (V+), TP1.1; also elsewhere on the board
/ADC/CLK: J3.3; also elsewhere on the board
/ADC/CS1: J3.2; also elsewhere on the board
/ADC/MISO: J3.4; also elsewhere on the board
/ADC/MOSI: J3.5; also elsewhere on the board
/CC Sink/DIAG: J3.7; also elsewhere on the board
/CC Sink/VIR-RTN: J4.1; also elsewhere on the board
/Connectors/CS0: J3.6; also elsewhere on the board
GND: J1.1, J2.A1, J2.A12, J2.B1, J2.B12, J2.SH1, J2.SH2, J2.SH3, J2.SH4, J3.8, J5.A1, J5.A12, J5.B1, J5.B12, J5.SH1, J5.SH2, J5.SH3, J5.SH4, J6.4 (GND), J6.5 (SH), TP2.1; also elsewhere on the board
VIR: J4.2; also elsewhere on the board

Notes on the sheet:
Power Input
Raspberry Pi5 Power Only
LED Strip (Optional)
Screw Terminal 36V @ 6 - 15A
MOSI is STROBE
7-pin 100mil
USB-C 5V @ 5A
Screw Terminal 5V @ 5.1A+
USB-A 5V
Strobe Output
SPI & GPIO

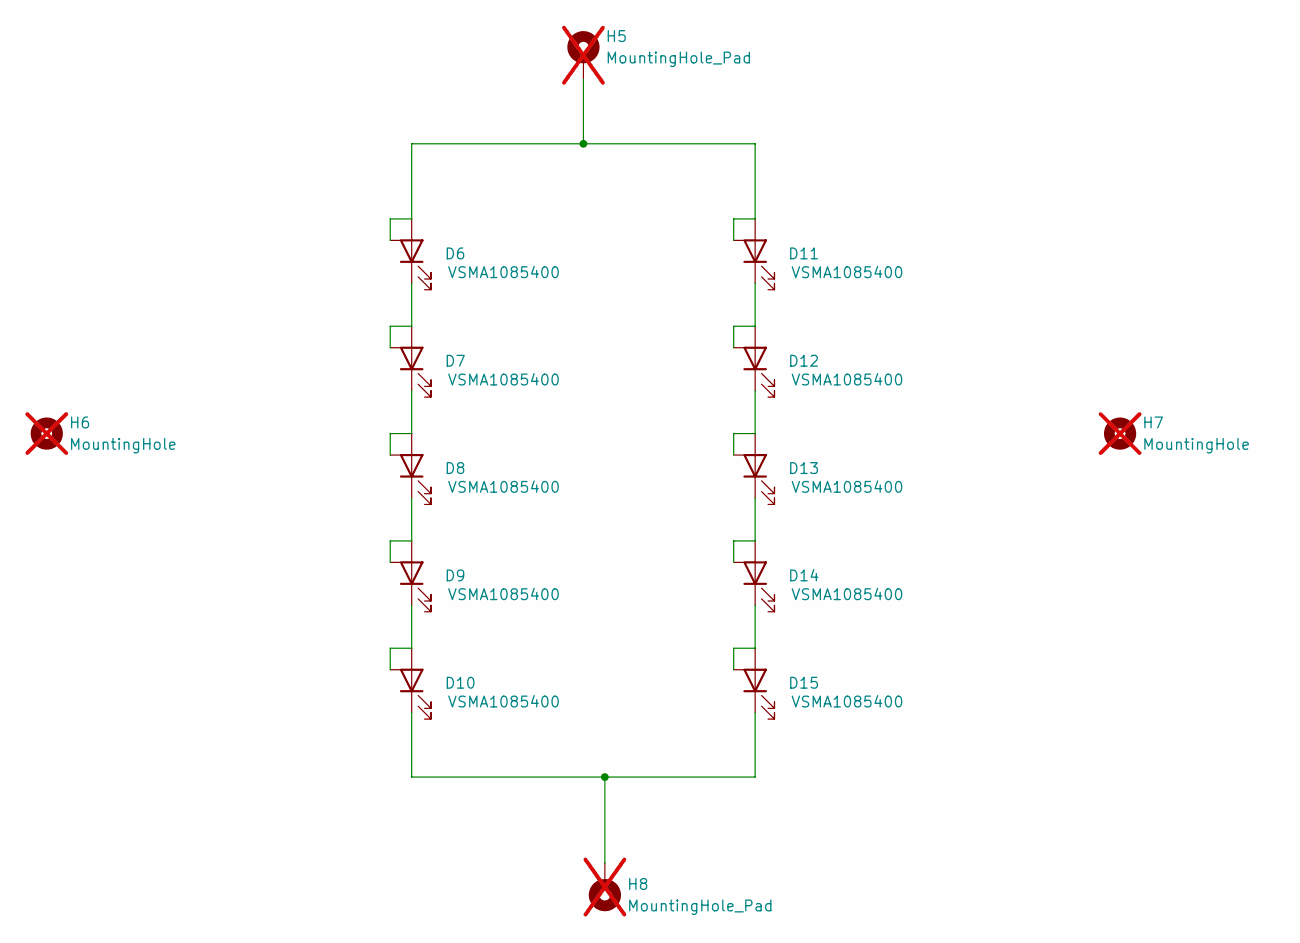
[picture p18: schematic IRLED-codex.kicad_sch, V3 Connector + IRLED]

Parts:
D6, D7, D8, D9, D10, D11, D12, D13, D14, D15: VSMA1085400; VSMA1085400-codex; Part Number VSMA1085400
H5, H8: MountingHole_Pad; MountingHole_2.2mm_M2_Pad; not fitted
H6, H7: MountingHole; MountingHole_3.2mm_M3; not fitted

Connections:
unnamed: D6.1 (K), D7.2 (A), D7.3
unnamed: D7.1 (K), D8.2 (A), D8.3
unnamed: D8.1 (K), D9.2 (A), D9.3
unnamed: D9.1 (K), D10.2 (A), D10.3
unnamed: D10.1 (K), D15.1 (K), H8.1
unnamed: D6.2 (A), D6.3, D11.2 (A), D11.3, H5.1
unnamed: D11.1 (K), D12.2 (A), D12.3
unnamed: D12.1 (K), D13.2 (A), D13.3
unnamed: D13.1 (K), D14.2 (A), D14.3
unnamed: D14.1 (K), D15.2 (A), D15.3

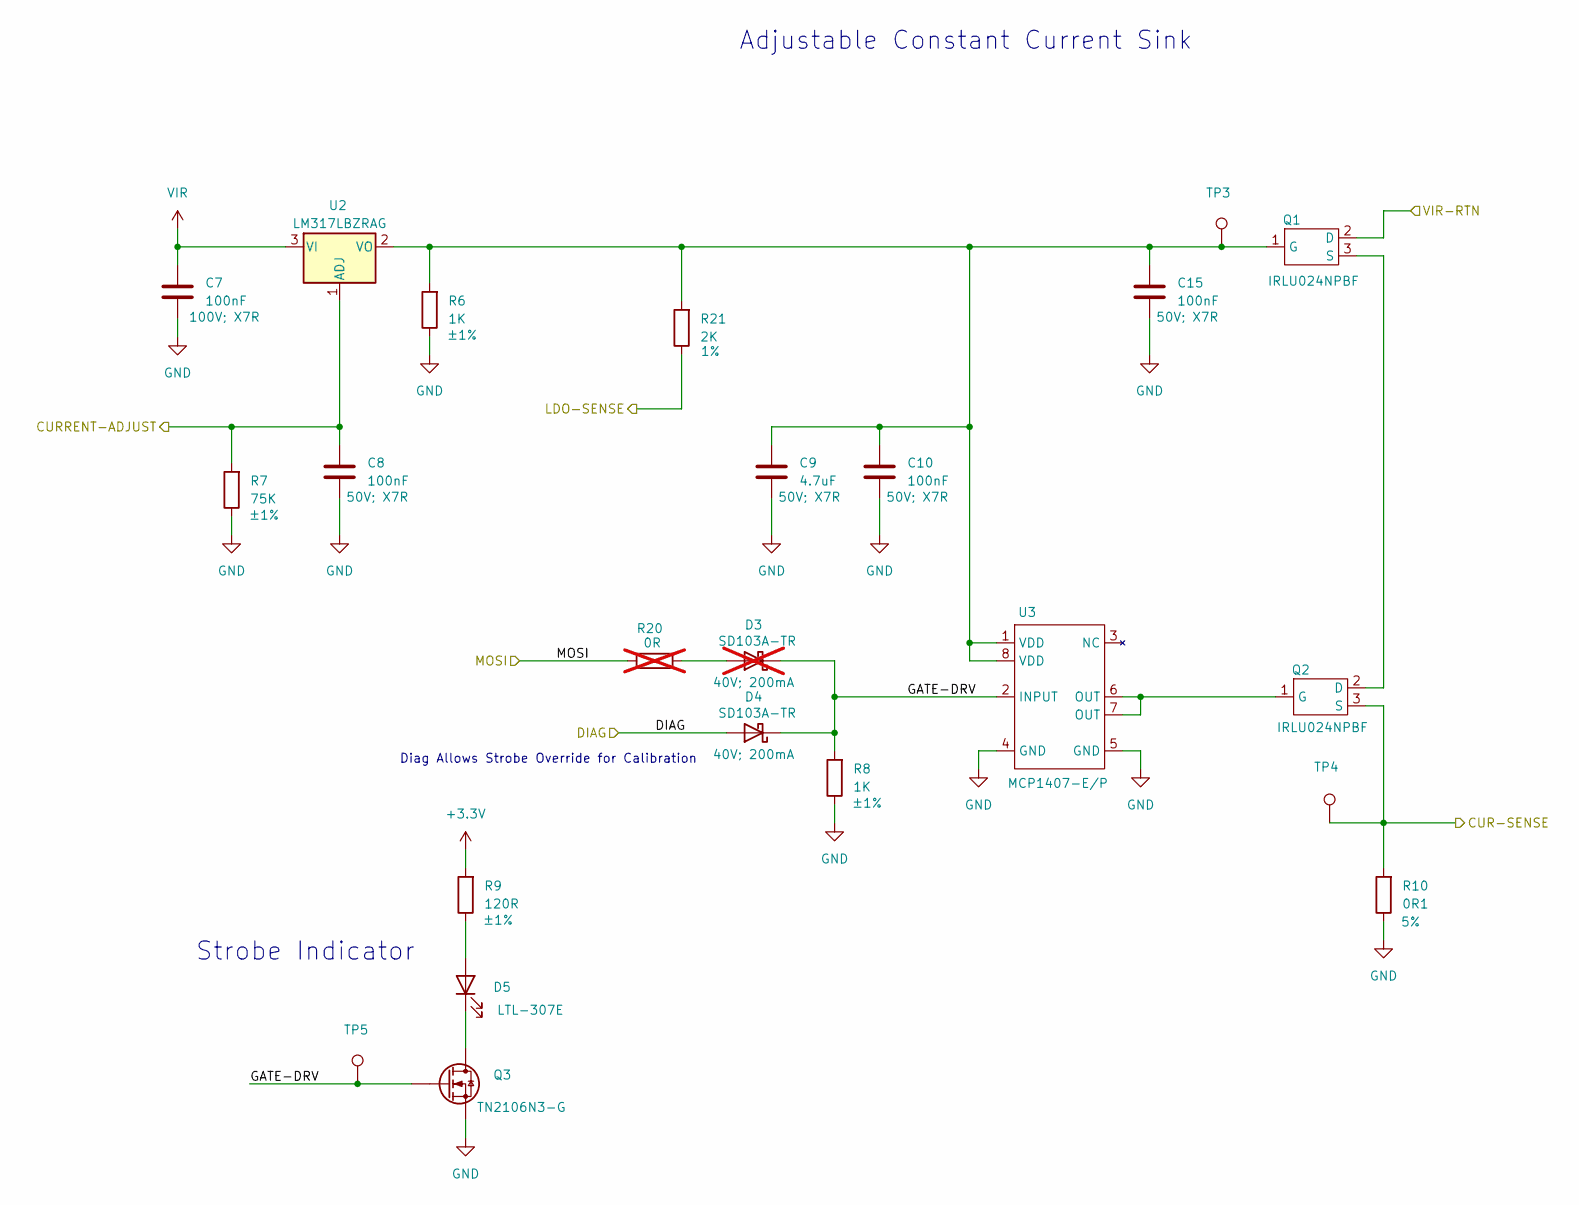
[picture p19: schematic Strobe Generation-codex.kicad_sch, V3 Connector + IRLED]

Parts:
C7: 100nF; C_Disc_D5.1mm_W3.2mm_P5.00mm; Ratings 100V; X7R; Part Number K104K20X7RH5UH5
C8, C10, C15: 100nF; C_Disc_D4.3mm_W1.9mm_P5.00mm; Ratings 50V; X7R; Part Number K104K10X7RF5UH5
C9: 4.7uF; C_Disc_D6.0mm_W4.4mm_P5.00mm; Ratings 50V; X7R; Part Number RCER71H475K3K1H03B
D3: D_Schottky; D_DO-35_SOD27_P7.62mm_Horizontal; Ratings 40V; 200mA; Part Number SD103A-TR; not fitted
D4: D_Schottky; D_DO-35_SOD27_P7.62mm_Horizontal; Ratings 40V; 200mA; Part Number SD103A-TR
D5: LTL-307E; LED_D5.0mm; Part Number LTL-307E
Q1, Q2: IRLU024NPBF; TO-251-3_Vertical; Part Number IRLU024NPBF
Q3: Q_NMOS; TO-92_Inline_Wide; Part Number TN2106N3-G
R6, R8: 1K; R_Axial_DIN0207_L6.3mm_D2.5mm_P7.62mm_Horizontal; Ratings ±1%; Part Number MFR-25FRF52-1K
R7: 75K; R_Axial_DIN0207_L6.3mm_D2.5mm_P7.62mm_Horizontal; Ratings ±1%; Part Number MFR-25FRF52-75K
R9: 120R; R_Axial_DIN0207_L6.3mm_D2.5mm_P7.62mm_Horizontal; Ratings ±1%; Part Number MFR-25FTE52-120R
R10: 0R1; R_Axial_DIN0414_L11.9mm_D4.5mm_P15.24mm_Horizontal; Ratings 5%; Part Number KNP100JR-73-0R1
R20: 0R; R_Axial_DIN0207_L6.3mm_D2.5mm_P7.62mm_Horizontal; Part Number ZOR-25-R-52-0R; not fitted
R21: 2K; R_Axial_DIN0207_L6.3mm_D2.5mm_P7.62mm_Horizontal; Ratings 1%; Part Number MFR-25FRF52-2K
TP3, TP4, TP5: TestPoint; TestPoint_Pad_D1.0mm
U2: TO-92_Inline_Wide; Part Number LM317LBZRAG
U3: DIP-8_W7.62mm; Part Number MCP1407-E/P

Connections:
+3.3V: R9.2; also elsewhere on the board
/ADC/CUR-SENSE: Q2.3 (S), R10.2, TP4.1; also elsewhere on the board
/ADC/LDO-SENSE: R21.1; also elsewhere on the board
/ADC/MOSI: R20.2; also elsewhere on the board
/CC Sink/CURRENT-ADJUST: C8.1, R7.2, U2.1 (ADJ); also elsewhere on the board
/CC Sink/DIAG: D4.2 (A); also elsewhere on the board
/CC Sink/GATE-DRV: D3.1 (K), D4.1 (K), Q3.2, R8.2, TP5.1, U3.2 (INPUT)
/CC Sink/VIR-RTN: Q1.2 (D); also elsewhere on the board
GND: C7.2, C8.2, C9.2, C10.2, C15.2, Q3.1, R6.1, R7.1, R8.1, R10.1, U3.4 (GND), U3.5 (GND); also elsewhere on the board
unnamed: D3.2 (A), R20.1
unnamed: D5.2 (A), R9.1
unnamed: D5.1 (K), Q3.3
unnamed: C9.1, C10.1, C15.1, Q1.1 (G), R6.2, R21.2, TP3.1, U2.2 (VO), U3.1 (VDD), U3.8 (VDD)
unnamed: Q1.3 (S), Q2.2 (D)
unnamed: Q2.1 (G), U3.6 (OUT), U3.7 (OUT)
VIR: C7.1, U2.3 (VI); also elsewhere on the board

Notes on the sheet:
Diag Allows Strobe Override for Calibration
Adjustable Constant Current Sink
Strobe Indicator

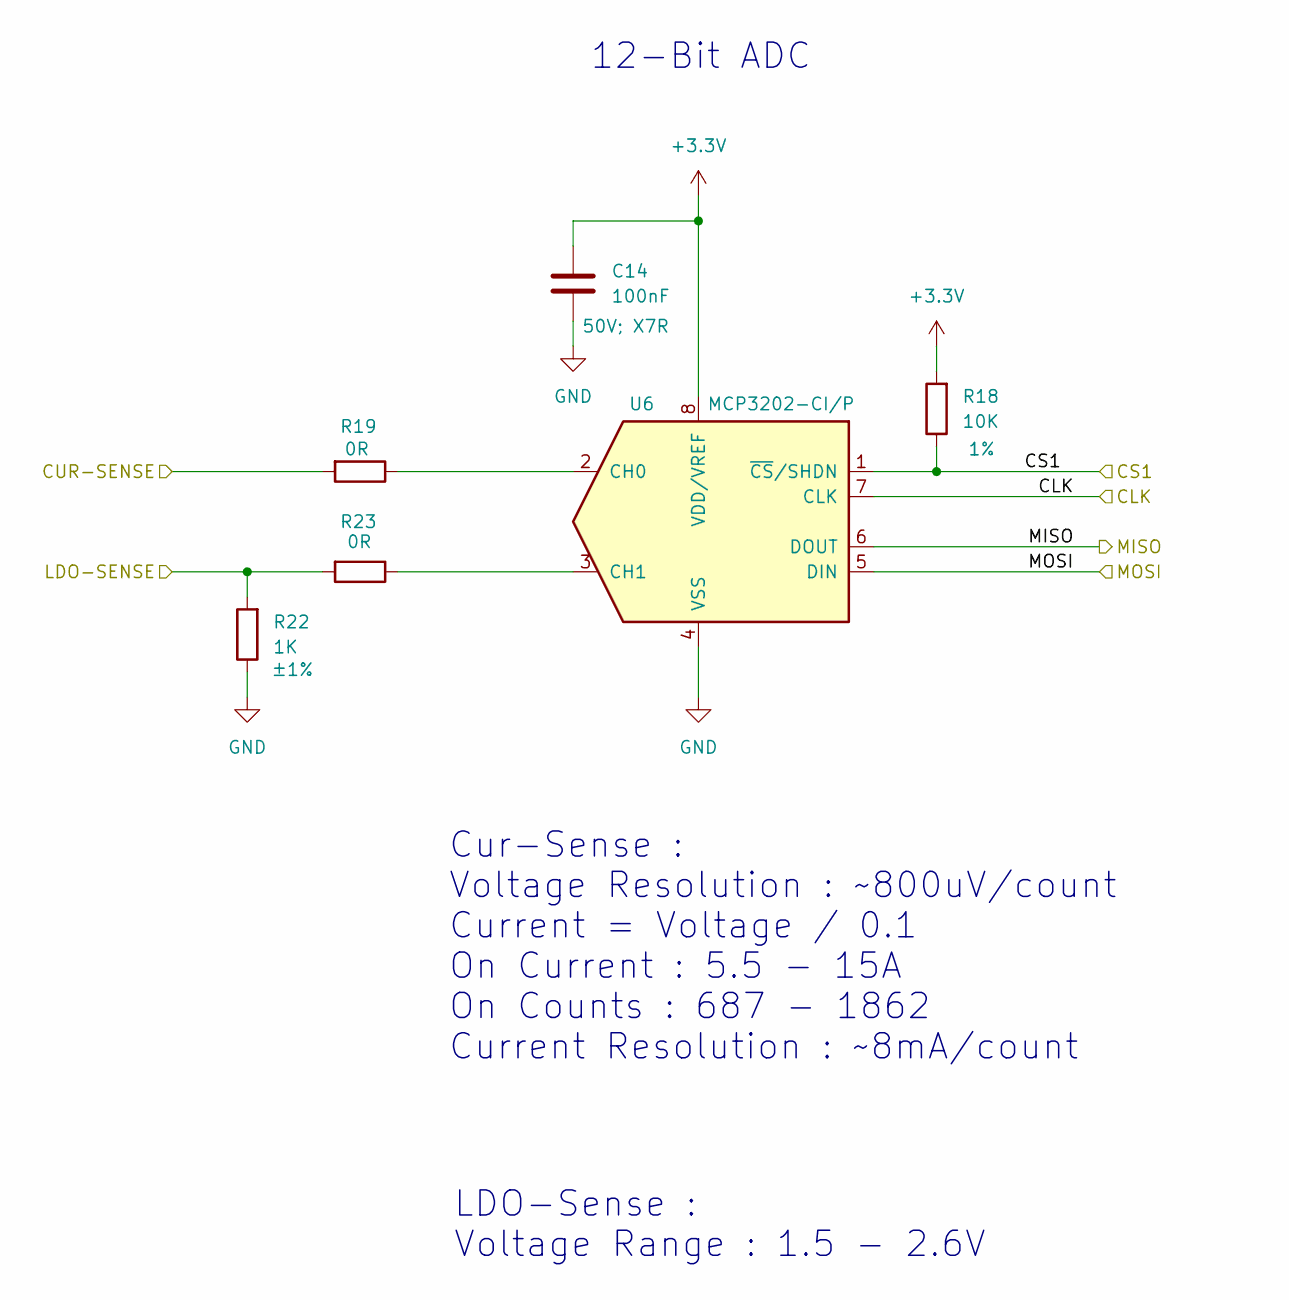
[picture p20: schematic ADC-codex.kicad_sch, V3 Connector + IRLED]

Parts:
C14: 100nF; C_Disc_D4.3mm_W1.9mm_P5.00mm; Ratings 50V; X7R; Part Number K104K10X7RF5UH5
R18: 10K; R_Axial_DIN0207_L6.3mm_D2.5mm_P7.62mm_Horizontal; Ratings 1%; Part Number MFR-25FRF52-10K
R19, R23: 0R; R_Axial_DIN0207_L6.3mm_D2.5mm_P15.24mm_Horizontal; Part Number ZOR-25-R-52-0R
R22: 1K; R_Axial_DIN0207_L6.3mm_D2.5mm_P7.62mm_Horizontal; Ratings ±1%; Part Number MFR-25FRF52-1K
U6: MCP3202; DIP-8_W7.62mm; Part Number MCP3202-CI/P

Connections:
+3.3V: C14.1, R18.2, U6.8 (VDD/VREF); also elsewhere on the board
/ADC/CLK: U6.7 (CLK); also elsewhere on the board
/ADC/CS1: R18.1, U6.1 (~CS/SHDN); also elsewhere on the board
/ADC/CUR-SENSE: R19.2; also elsewhere on the board
/ADC/LDO-SENSE: R22.2, R23.2; also elsewhere on the board
/ADC/MISO: U6.6 (DOUT); also elsewhere on the board
/ADC/MOSI: U6.5 (DIN); also elsewhere on the board
GND: C14.2, R22.1, U6.4 (VSS); also elsewhere on the board
unnamed: R19.1, U6.2 (CH0)
unnamed: R23.1, U6.3 (CH1)

Notes on the sheet:
Cur-Sense : Voltage Resolution : ~800uV/count Current = Voltage / 0.1 On Current : 5.5 - 15A On Counts : 687 - 1862 Current Resolution : ~8mA/count
LDO-Sense : Voltage Range : 1.5 - 2.6V
12-Bit ADC

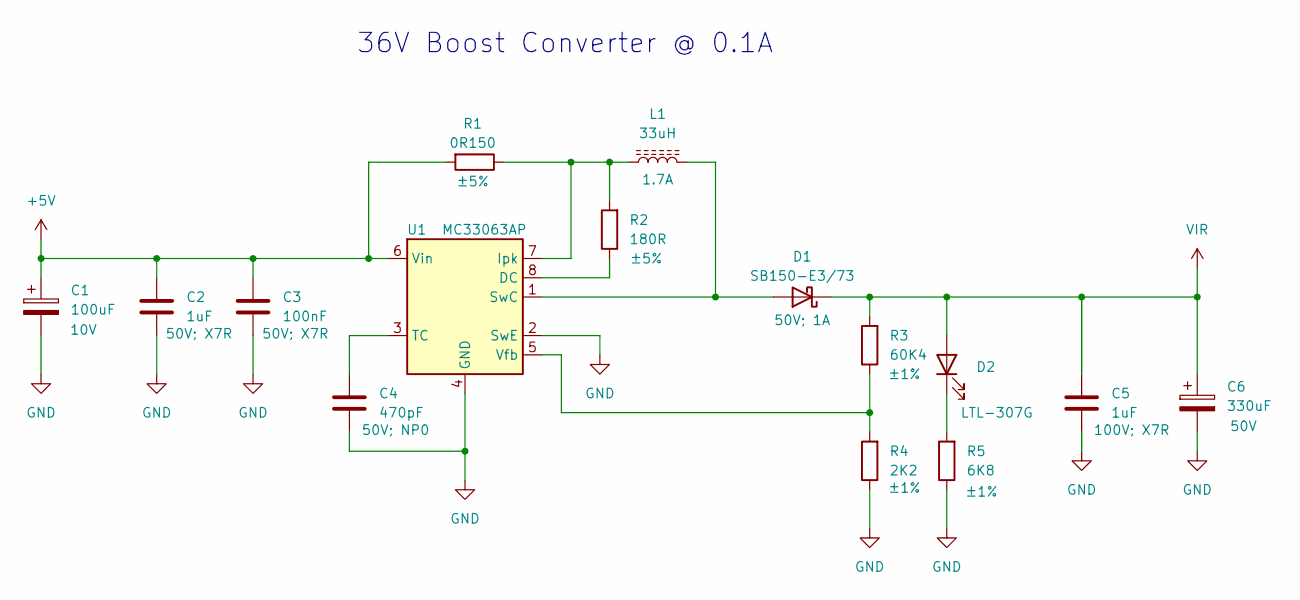
[picture p21: schematic Power-codex.kicad_sch, V3 Connector + IRLED]

Parts:
C1: 100uF; CP_Radial_D5.0mm_P2.00mm; Ratings 10V; Part Number A750BK107M1AAAE024
C2: 1uF; C_Disc_D5.1mm_W3.2mm_P5.00mm; Ratings 50V; X7R; Part Number K105K20X7RF5TH5
C3: 100nF; C_Disc_D4.3mm_W1.9mm_P5.00mm; Ratings 50V; X7R; Part Number K104K10X7RF5UH5
C4: 470pF; C_Disc_D4.7mm_W2.5mm_P5.00mm; Ratings 50V; NP0; Part Number K471J15C0GF5UH5
C5: 1uF; C_Disc_D5.1mm_W3.2mm_P5.00mm; Ratings 100V; X7R; Part Number RDER72A105K2M1H03A
C6: 330uF; CP_Radial_D10.0mm_P5.00mm; Ratings 50V; Part Number A750MW337M1HAAE020
D1: SB150-E3/73; D_DO-41_SOD81_P10.16mm_Horizontal; Ratings 50V; 1A; Part Number SB150-E3/73
D2: LTL-307G; LED_D5.0mm; Part Number LTL-307G
L1: 33uH; L_Radial_D8.7mm_P5.00mm_Fastron_07HCP; Ratings 1.7A; Part Number RLB0914-330KL
R1: 0R150; R_Axial_DIN0516_L15.5mm_D5.0mm_P20.32mm_Horizontal; Ratings ±5%; Part Number PNP300JR-73-0R15
R2: 180R; R_Axial_DIN0207_L6.3mm_D2.5mm_P10.16mm_Horizontal; Ratings ±5%; Part Number KNP1WSJT-52-180R
R3: 60K4; R_Axial_DIN0207_L6.3mm_D2.5mm_P7.62mm_Horizontal; Ratings ±1%; Part Number MFR-25FRF52-60K4
R4: 2K2; R_Axial_DIN0207_L6.3mm_D2.5mm_P7.62mm_Horizontal; Ratings ±1%; Part Number MFR-25FRF52-2K2
R5: 6K8; R_Axial_DIN0207_L6.3mm_D2.5mm_P7.62mm_Horizontal; Ratings ±1%; Part Number MFR-25FTE52-6K8
U1: MC33063AP; DIP-8_W7.62mm; Part Number MC33063AP

Connections:
+5V: C1.1, C2.1, C3.1, R1.2, U1.6 (Vin); also elsewhere on the board
GND: C1.2, C2.2, C3.2, C4.1, C5.2, C6.2, R4.1, R5.1, U1.2 (SwE), U1.4 (GND); also elsewhere on the board
unnamed: D1.2 (A), L1.2, U1.1 (SwC)
unnamed: D2.1 (K), R5.2
unnamed: R2.1, U1.8 (DC)
unnamed: L1.1, R1.1, R2.2, U1.7 (Ipk)
unnamed: C4.2, U1.3 (TC)
unnamed: R3.1, R4.2, U1.5 (Vfb)
VIR: C5.1, C6.1, D1.1 (K), D2.2 (A), R3.2; also elsewhere on the board

Notes on the sheet:
36V Boost Converter @ 0.1A

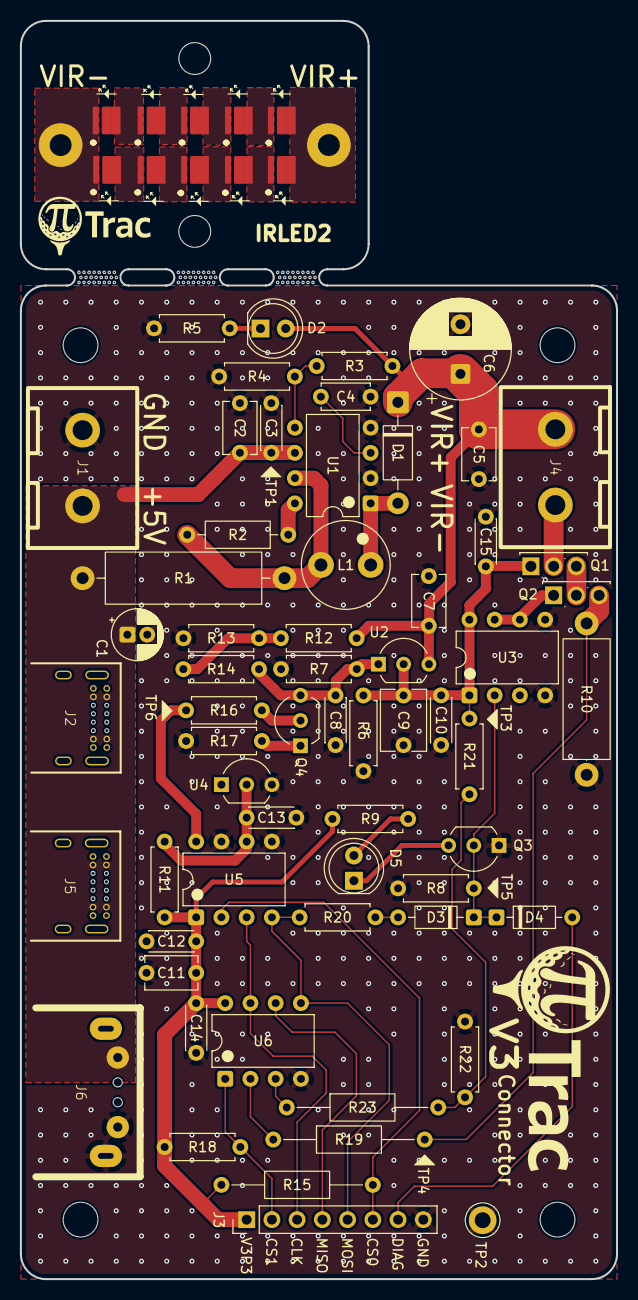
[picture p22: board V3 Connector + IRLED-codex.kicad_pcb from above]

Board: 2 copper layers, 60.0 x 126.6 mm, 79 parts (0 on the bottom side), 44 nets.
