cmc0619/PiTrac/(commit log)

2026-10-24 V3 connector board: strobe pulse limiter, USB-C fixes, boost protection
    Mechanical: board outline, all mounting/tab/breakaway holes and every
    existing part position are unchanged (checked against the previous revision);
    all new parts are on the top side and no taller than existing parts.
    PiTrac software compatibility: the LED current-control circuit and the
    DAC/ADC/DIAG interface used by strobe_calibration_manager.py are unchanged.
    Strobe (CC Sink sheet)
    - AC-coupled pulse limiter: TRIG (DIAG/MOSI via D3/D4) -> C16 220nF ->
    GATE-DRV, R28 10K to GND (tau 2.2 ms). 8.7-130 us strobes and the
    calibration pulse pass (guaranteed >= ~0.38 ms by the MCP1407 input
    limits); a stuck-high DIAG tu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
    [Connectors.kicad_sch, DAC.kicad_sch, IRLED.kicad_sch, Power.kicad_sch, Strobe Generation.kicad_sch, V3 Connector + IRLED.kicad_pcb, V3 Connector + IRLED2 Bill of Materials.csv, V3 Connector + IRLED2 Centroid.csv]
2026-10-24 C16: use an orderable part (K224K20X7RF5UH5, 220nF 50V X7R)
    K224K15X7RF5UH5 isn't listed by any distributor; the "20" (50 V) code is the
    real 220 nF part in this Vishay K series (DigiKey 2356767, element14
    2860121). Footprint moved to C_Disc_D5.1mm_W3.2mm_P5.00mm, the one already
    used for C2 (1 uF in the same series), so the body fits.
    Outputs regenerated; ERC/DRC unchanged (0 errors), geometry unchanged.
    [Strobe Generation.kicad_sch, V3 Connector + IRLED.kicad_pcb, V3 Connector + IRLED2 Bill of Materials.csv, V3 Connector + IRLED2 Centroid.csv, V3 Connector Only Bill of Materials.csv, V3 Connector Only Centroid.csv, V3 Connector Only.kicad_pcb]
2026-10-24 Address PR review: R5 part number, timing bounds, library defaults, ERC scope
    - R5: PCB Part Number field still named the old MFR-25FTE52-2K49 on both
    boards; now MFR-25FRF52-10K, matching the schematic and BOM. (The stage-A
    update changed the value but not the BOM fields; no other part drifted.)
    - Limiter note: worst-case bounds now include R28 1%, C16 +-10% plus X7R
    drift and a 2.7-2.95 V start level: cutoff <= ~3.2 ms, pass >= ~0.2 ms
    worst case (~1.7 ms typical for both).
    - USB-C labels: "3A advertised (CC), 5A max" instead of "5A" — the Rp
    pull-ups advertise Type-C 3 A; the connector/copper are rated 5 A.
    - Project library: default references Q4/Q1/D1 -> Q/Q/D; LED_ThermalPa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
    [Connectors.kicad_sch, DAC.kicad_sch, IRLED.kicad_sch, Strobe Generation.kicad_sch, V3 Connector + IRLED.kicad_pcb, V3 Connector Only.kicad_pcb]
2026-10-24 IR LEDs: connect the VSMA1085400 center pad (second anode) on both LED boards
    Vishay's package drawing (doc 80294) labels the VSMA1085400 pads Anode,
    Anode, Cathode; the wide center pad under the die is an anode contact, not
    an isolated thermal pad. The LED symbol was inherited from the earlier
    Luminus SST-10-IRD (whose center pad is isolated), so pad 3 was left on an
    isolated copper island and all strobe current went through the 0.35 mm
    outer anode pad.
    - Symbol: LED_ThermalPad -> VSMA1085400 (pin 3 named A, Vishay datasheet,
    description). D6-D15 pin 3 wired to pin 2; no-connect markers removed.
    - PCB (IRLED Only, and the LED tab of V3 Connector + IRLED): pad 3 on the
    LED's anode net w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
    [IRLED Only.kicad_pcb, IRLED.kicad_sch, V3 Connector + IRLED.kicad_pcb]
2026-11-04 fix(hardware): correct indicator load and PCB pad connections
    [Connectors.kicad_sch, DAC.kicad_sch, IRLED Only.kicad_pcb, IRLED.kicad_sch, Power.kicad_sch, Strobe Generation.kicad_sch, V3 Connector + IRLED.kicad_pcb, V3 Connector + IRLED2 Bill of Materials.csv]
2026-11-04 fix(hardware): reset connector-only BOM export destination
